BigMagnus6Tips/Sememsterprojekt-grundl-ggende-styring-af-robotter/Images/HardwareIntegrationNoLedOrShield.png

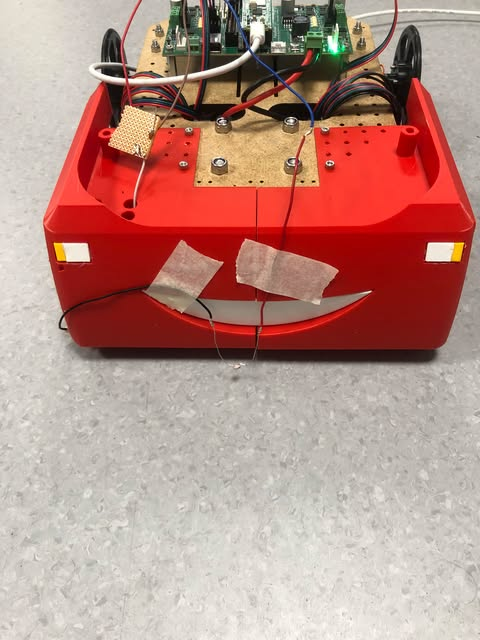
Images/HardwareIntegrationNoLedOrShield.png
