BigMagnus6Tips/Sememsterprojekt-grundl-ggende-styring-af-robotter/Images/Hardware_integration_1.1_pmr3.jpg

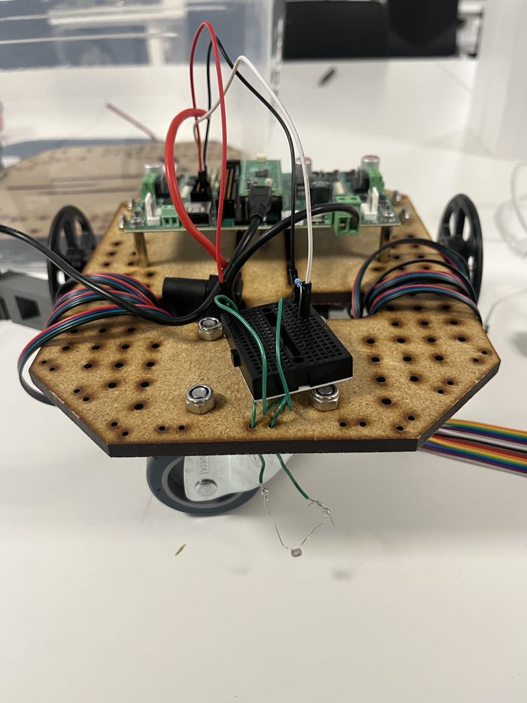
Images/Hardware_integration_1.1_pmr3.jpg
