BigMagnus6Tips/Sememsterprojekt-grundl-ggende-styring-af-robotter/Joystick controlled wireless robot.pptx

## Joystick controlled wireless robot

Lukas, Karl, Magne, Rasmus, Alexander og Nikolai

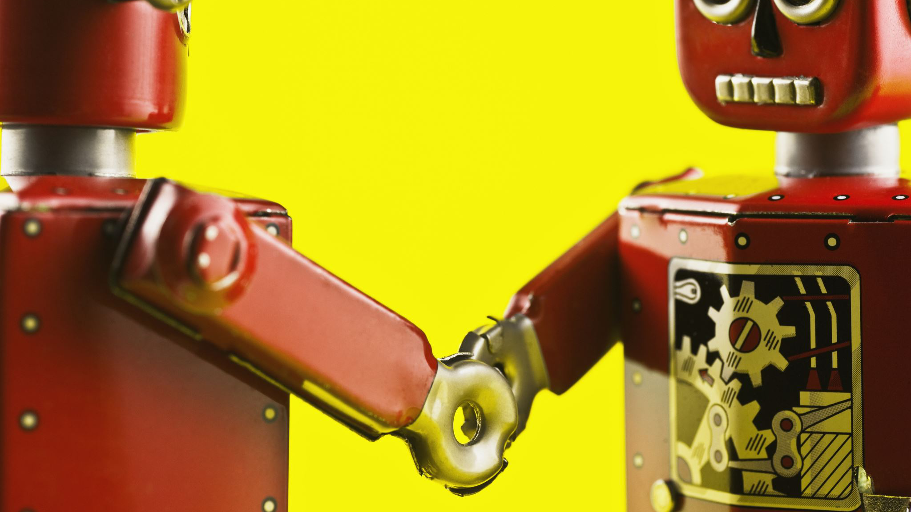
[picture p3: figure]
Toy robots shaking hands

## Introduction

- Concept and Objective

- Movement control
- Speed adjustment
- Controller
- LED’s, OLED, Joystick
- Wireless data communication
- Killswitch

- Solution

- Joystick class
- 3D print + PCB
- Bluetooth

## High-level overview

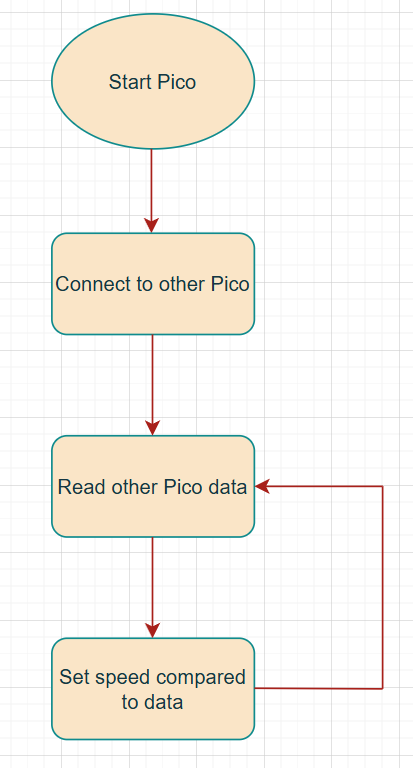
[picture p4: figure]
Et billede, der indeholder tekst, skærmbillede, diagram, linje/række Beskrivelsen er genereret automatisk
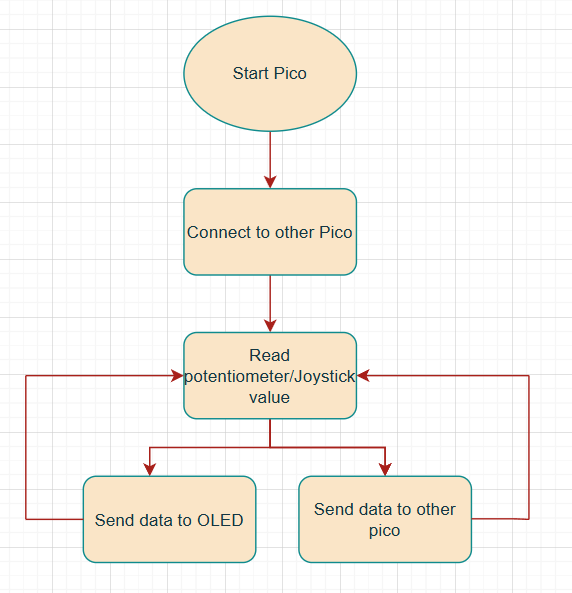
[picture p5: figure]
Et billede, der indeholder tekst, skærmbillede, diagram, Font/skrifttype Beskrivelsen er genereret automatisk

## Tools and Materials

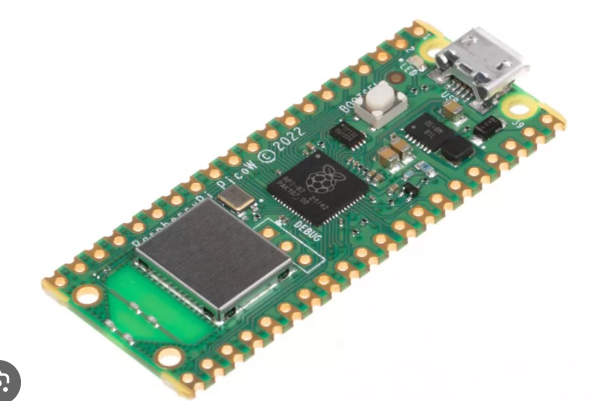
[picture p6: figure]
Et billede, der indeholder elektronik, Elektronisk komponent, Kredsløbskomponent, Passive kredsløbskomponenter Beskrivelsen er genereret automatisk

- Two pico WH’s
- PCB
- 3D print
- Killswitch
- Joystick
- LED
- OLED
- Resistors (2 Kohm)

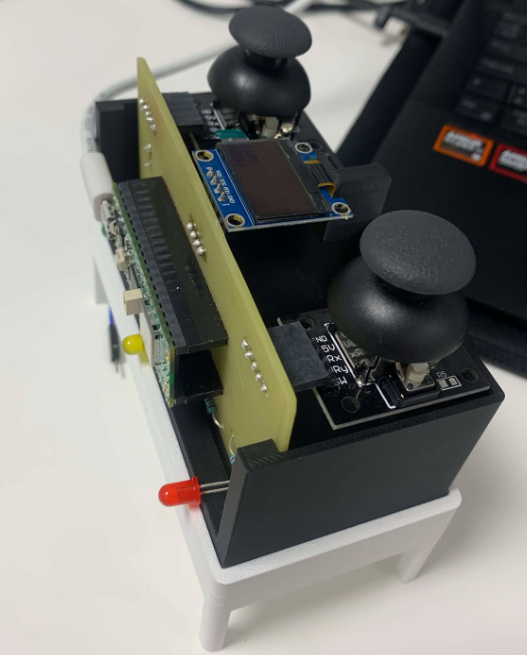
[picture p7: figure]
Et billede, der indeholder elektronik, Elektronisk enhed, Inputenhed, indendørs Beskrivelsen er genereret automatisk
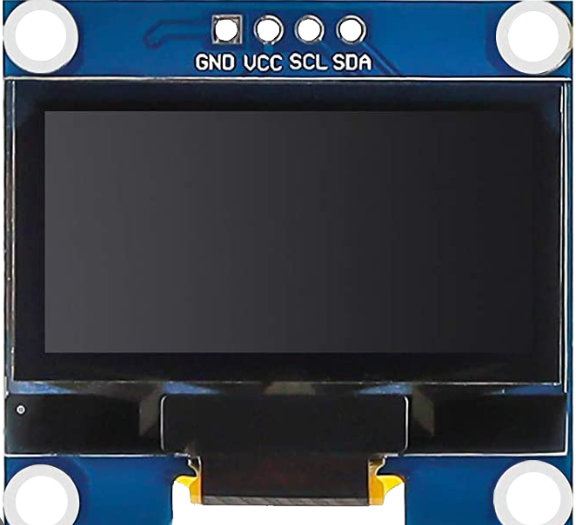
[picture p8: figure]
Et billede, der indeholder tekst, skærm, fjernsyn, skærmbillede Beskrivelsen er genereret automatisk

## Key features

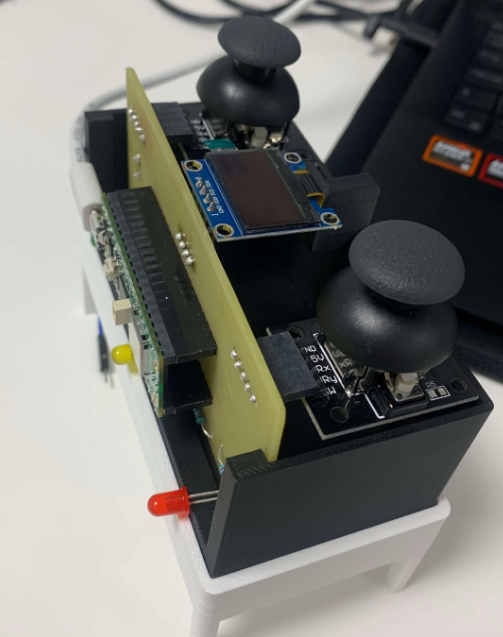
[picture p9: figure]
Et billede, der indeholder elektronik, Elektronisk enhed, Inputenhed, indendørs Beskrivelsen er genereret automatisk

Killswitch functionality
Joystick/Joystick
Move back -> forward -> left -> right
Wireless Bluetooth communication
OLED and LED integration

## Results

- 2 picos
- Bluetooth
- Controller
  - Our own print

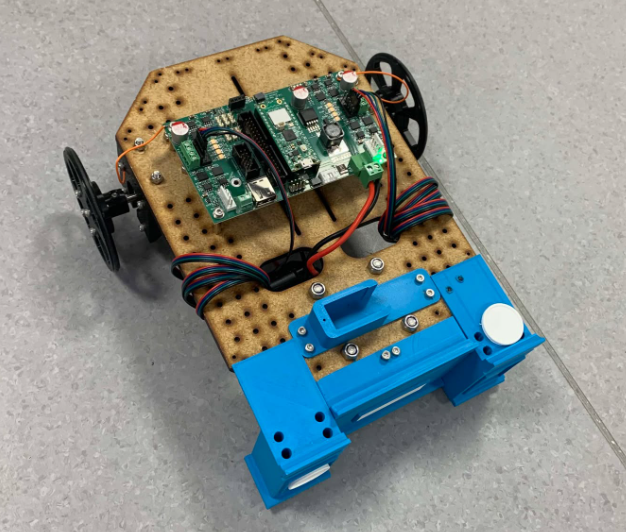
[picture p10: figure]
Et billede, der indeholder Kredsløbskomponent, Elektroteknik, Elektronisk komponent, Passive kredsløbskomponenter Beskrivelsen er genereret automatisk

## Some of the Code Joystick

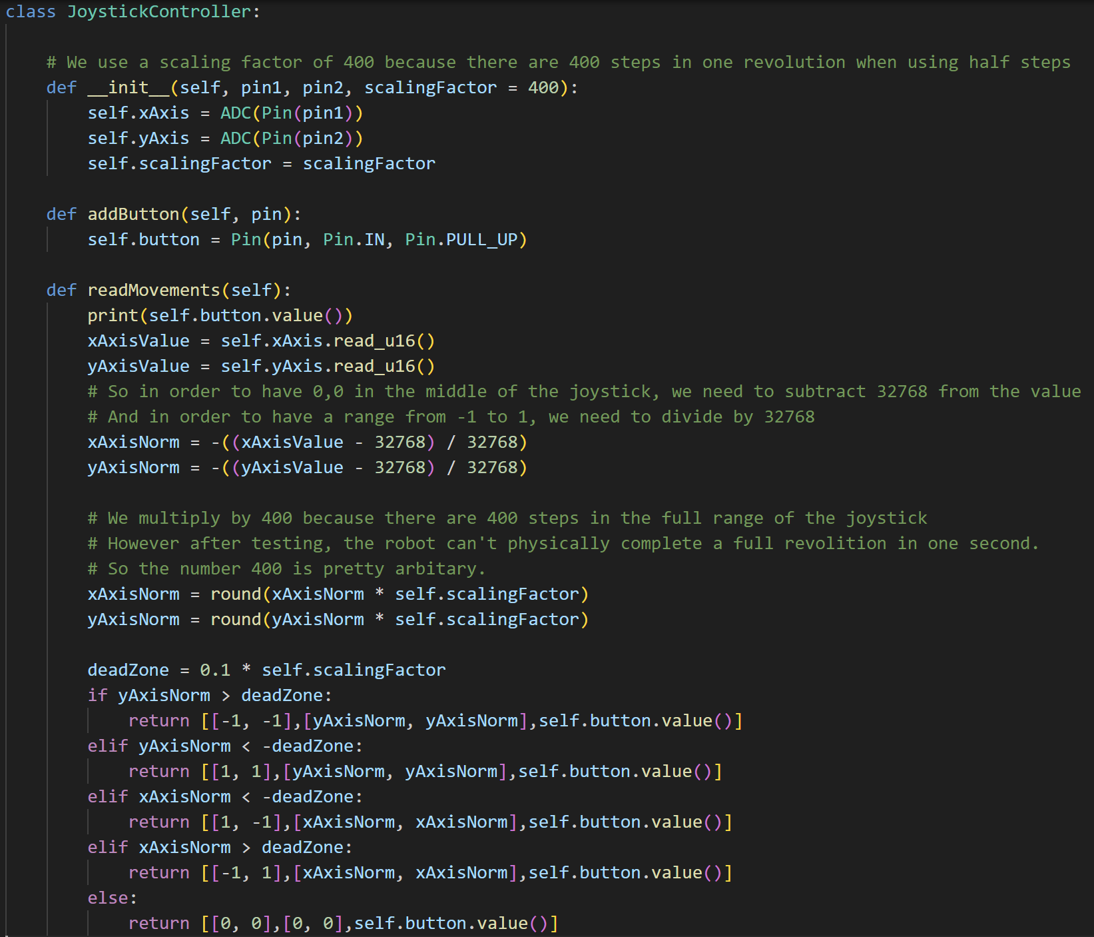
[picture p11: figure]
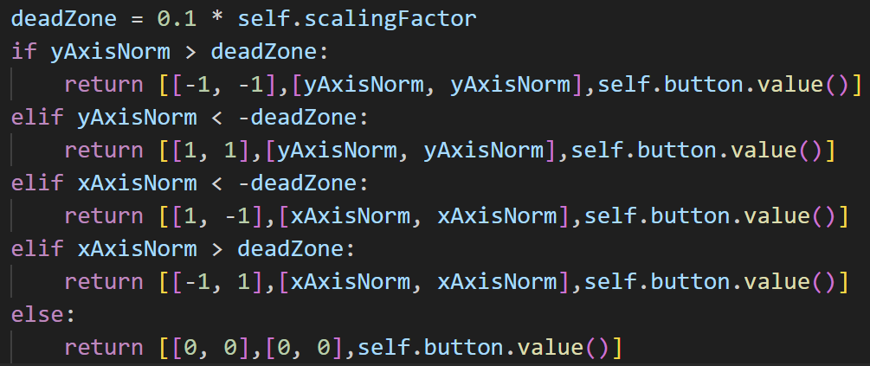
[picture p12: figure]

## Setup for Bluetooth

- Aioble
- Services and Characteristics
- Packets
  - Bytes

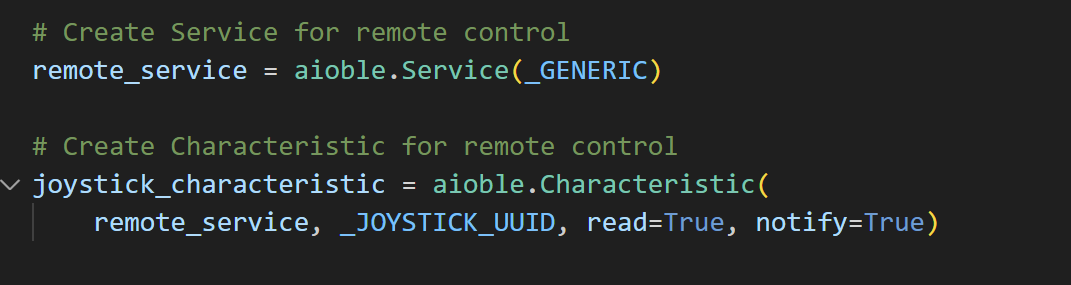
[picture p13: figure]
Et billede, der indeholder tekst, skærmbillede, Font/skrifttype Beskrivelsen er genereret automatisk
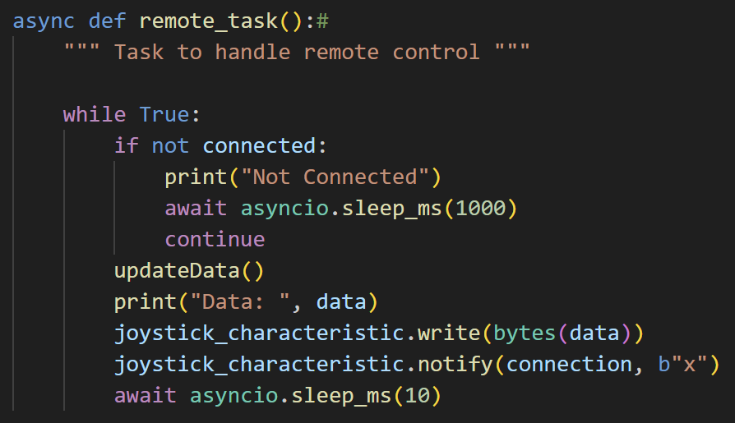
[picture p14: figure]
Et billede, der indeholder tekst, skærmbillede, Font/skrifttype Beskrivelsen er genereret automatisk

## Conversion to bytes

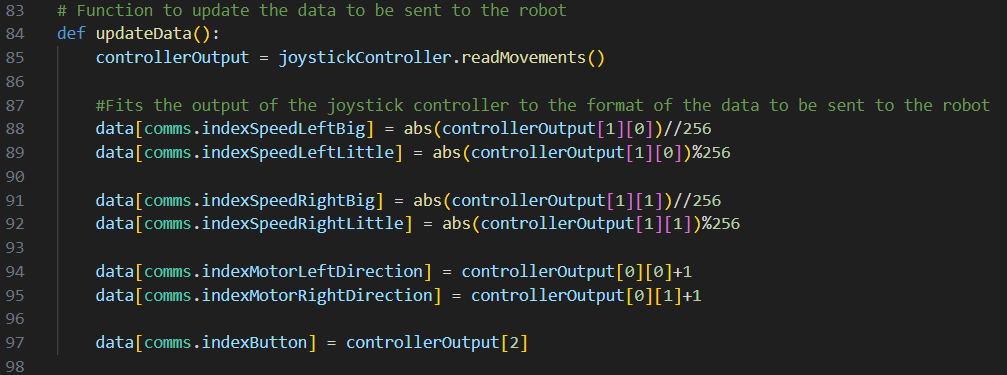
[picture p15: figure]

Bluetooth sends uint8
Bytes is 256 different values

## PrintBoard

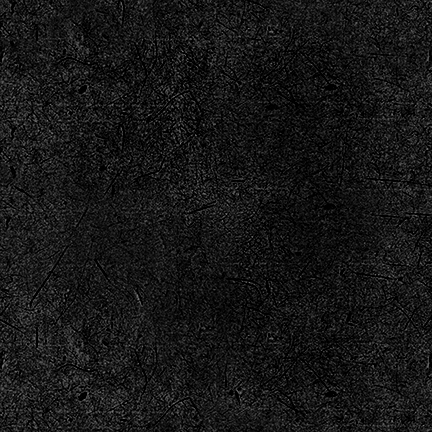
[picture p16: figure]
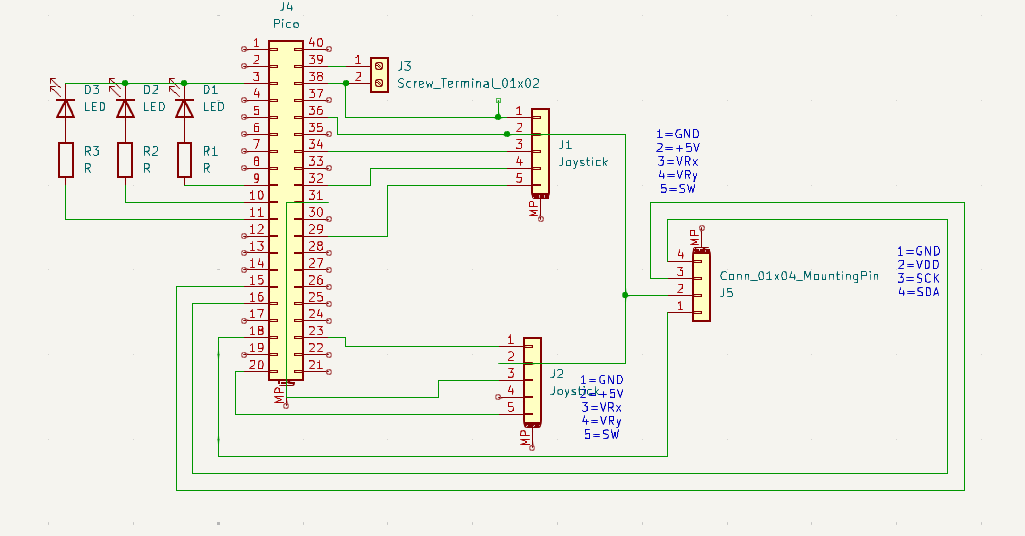
[picture p17: figure]
Et billede, der indeholder tekst, diagram, linje/række, Plan Beskrivelsen er genereret automatisk

KiCad
- Pico
- 2 x Joystick – Mounting pin 1x5
- OLED – Mounting pin 1x4
- Screw terminal
- LED – Pre-resitance
- Etching

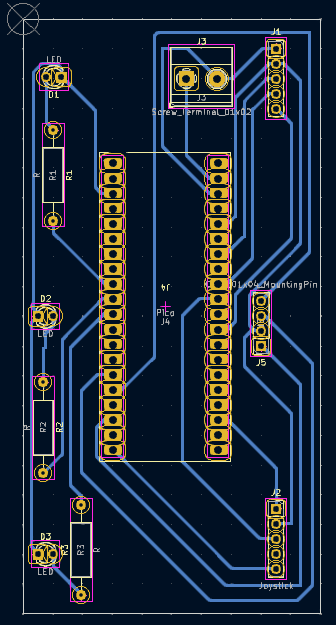
[picture p18: figure]
Et billede, der indeholder tekst, skærmbillede, kredsløb, design Beskrivelsen er genereret automatisk
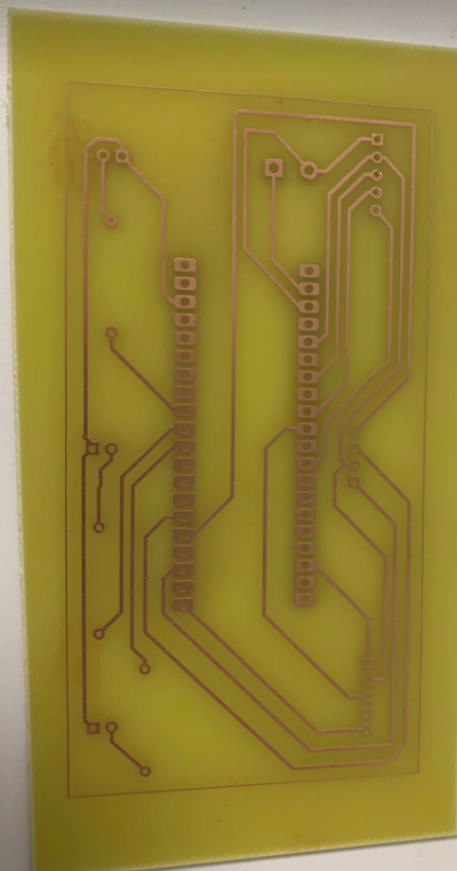
[picture p19: figure]
Et billede, der indeholder kunst, Rektangel, tegning Beskrivelsen er genereret automatisk

## Demonstration

- https://www.youtube.com/watch?v=Fvm5enrU_tU
- Springer lige det første min over... da vi står og forklarer

## Challenges

PCB soldering issues
Wireless wifi communication or bluetooth

## Conclusion and Improvements

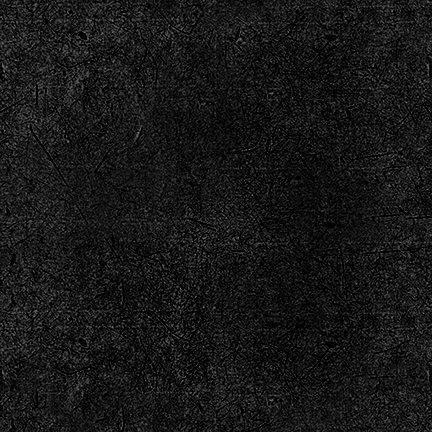
[picture p20: figure]
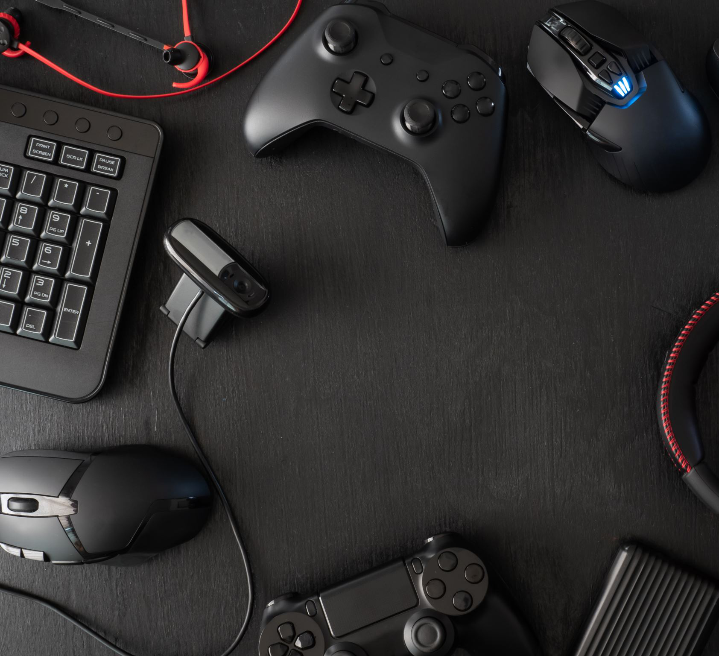
[picture p21: figure]
Gadgets på et skrivebord

- Full joystick control left/forward, right/backward etc.
- Double joystick integration (too few ADC pins)
