BigMagnus6Tips/Sememsterprojekt-grundl-ggende-styring-af-robotter/Images/CrazyPerfectGraph.png

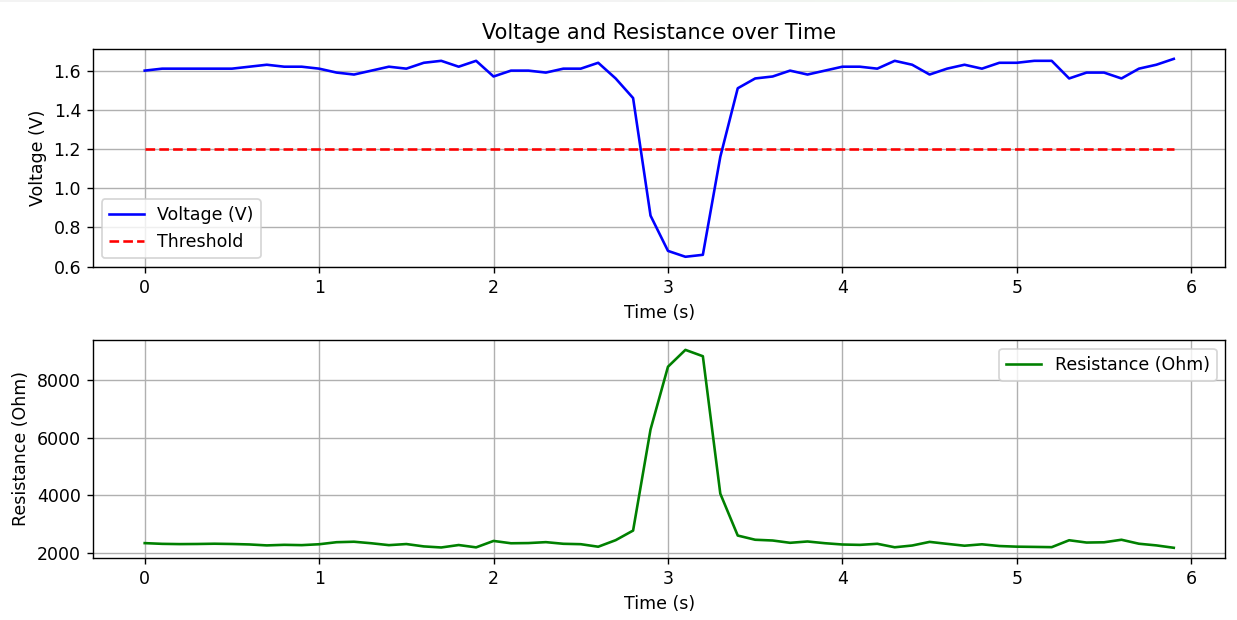
Images/CrazyPerfectGraph.png
