BigMagnus6Tips/Sememsterprojekt-grundl-ggende-styring-af-robotter/Images/Data_log_before_hardware.png

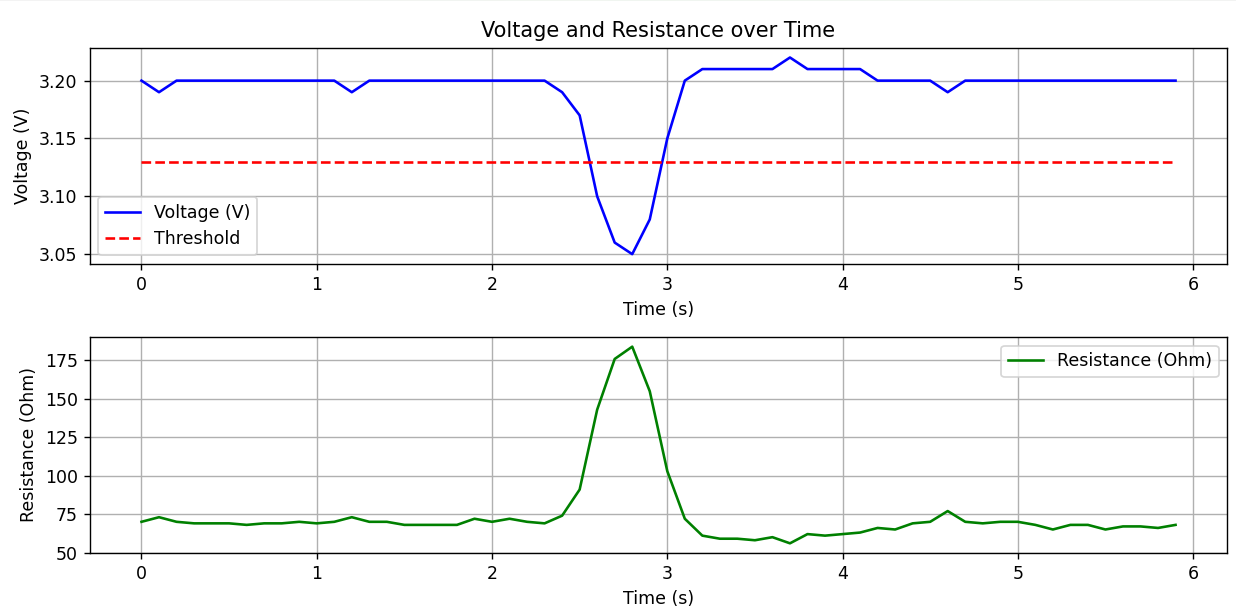
Images/Data_log_before_hardware.png
