BigMagnus6Tips/Sememsterprojekt-grundl-ggende-styring-af-robotter/Images/finalNoLEDButShieldGraph.png

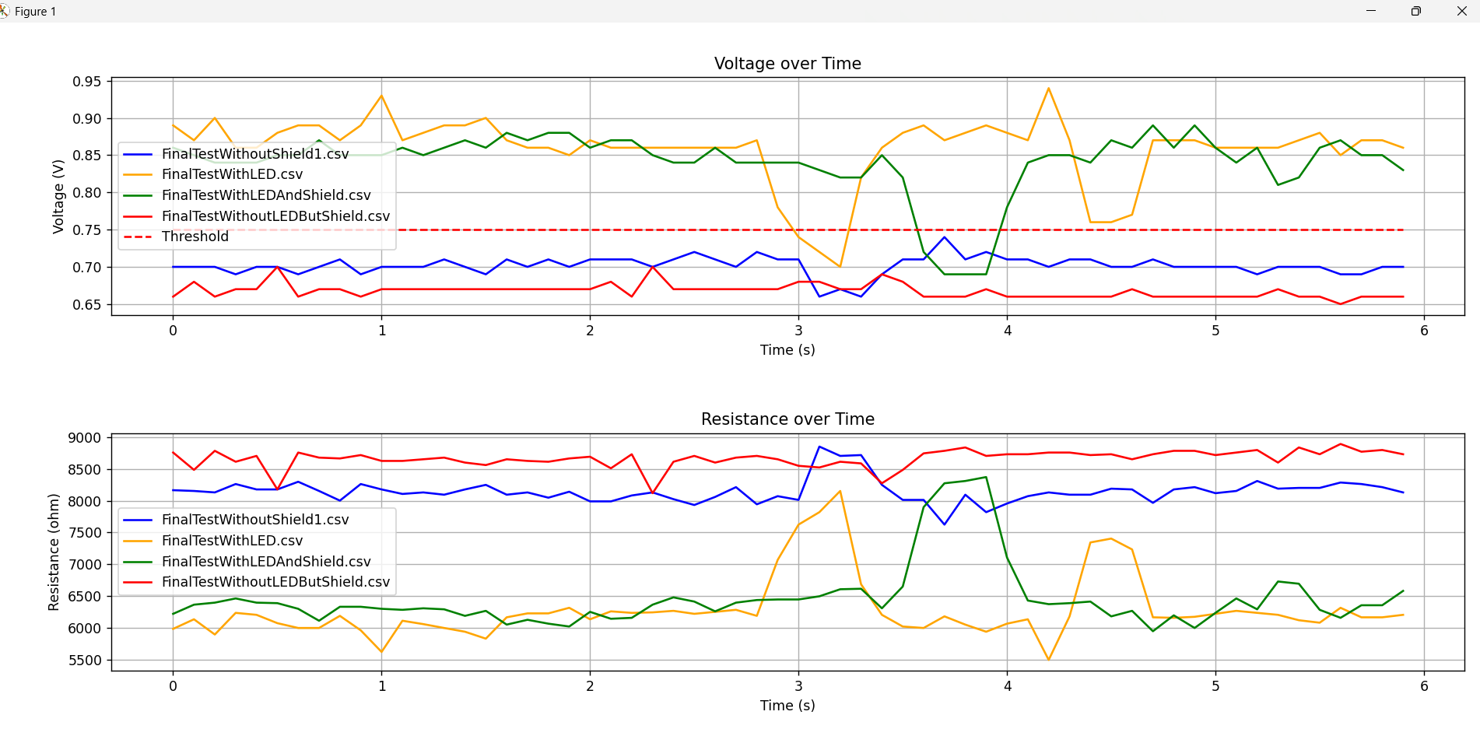
Images/finalNoLEDButShieldGraph.png
