BigMagnus6Tips/Sememsterprojekt-grundl-ggende-styring-af-robotter/Images/finalNoLedOrShield.png

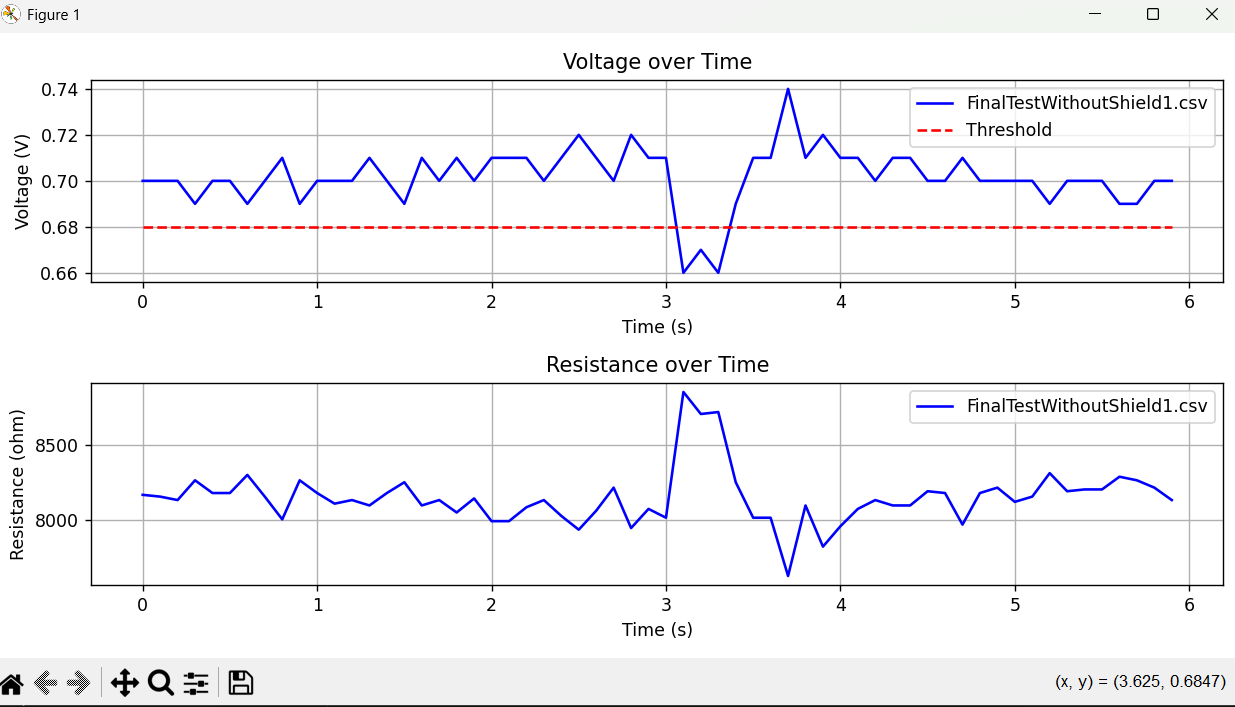
Images/finalNoLedOrShield.png
