BigMagnus6Tips/Sememsterprojekt-grundl-ggende-styring-af-robotter/Images/finalWithLedAndShield.png

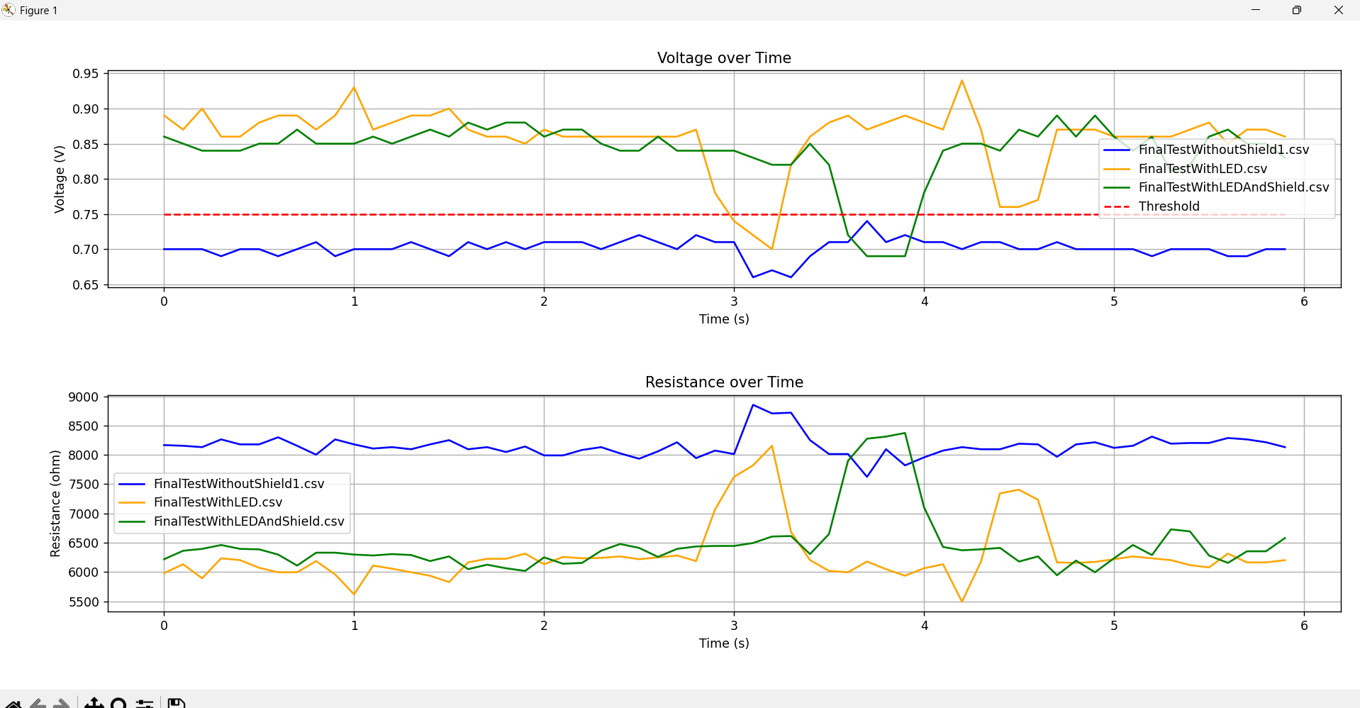
Images/finalWithLedAndShield.png
