BigMagnus6Tips/Sememsterprojekt-grundl-ggende-styring-af-robotter/Images/finalWithLEDNoShield.png

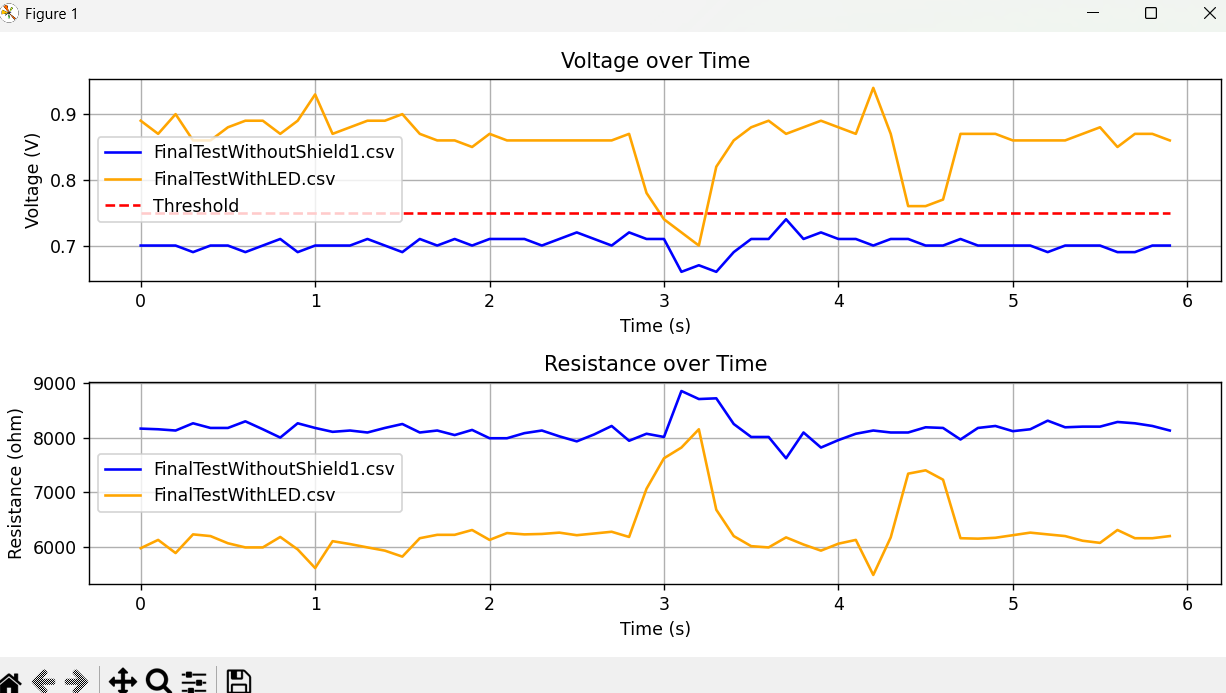
Images/finalWithLEDNoShield.png
