BigMagnus6Tips/Sememsterprojekt-grundl-ggende-styring-af-robotter/Images/Flowchart2.png

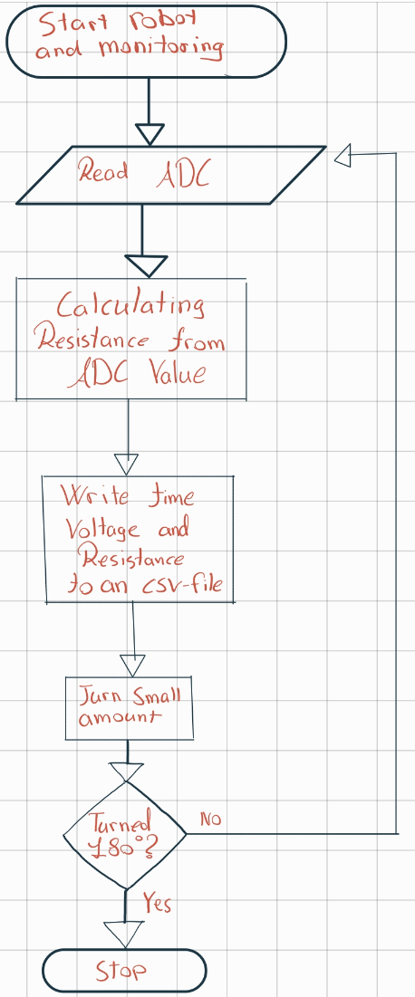
Images/Flowchart2.png
