BigMagnus6Tips/Sememsterprojekt-grundl-ggende-styring-af-robotter/Images/HardwareWithLedAndShield.png

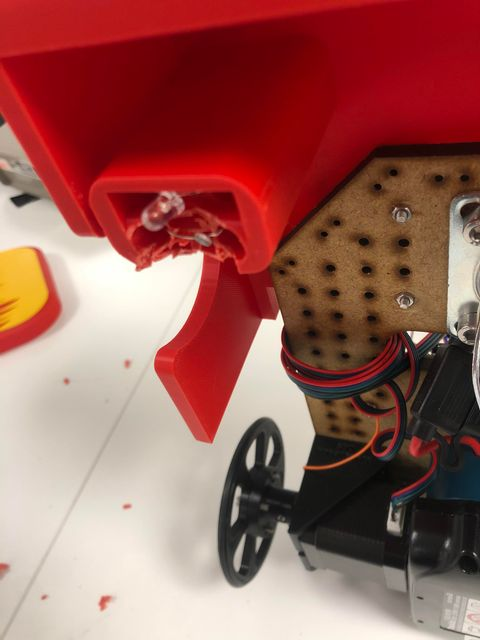
Images/HardwareWithLedAndShield.png
