BigMagnus6Tips/Sememsterprojekt-grundl-ggende-styring-af-robotter/Images/HardwareWithLedNoShiedIntegration.png

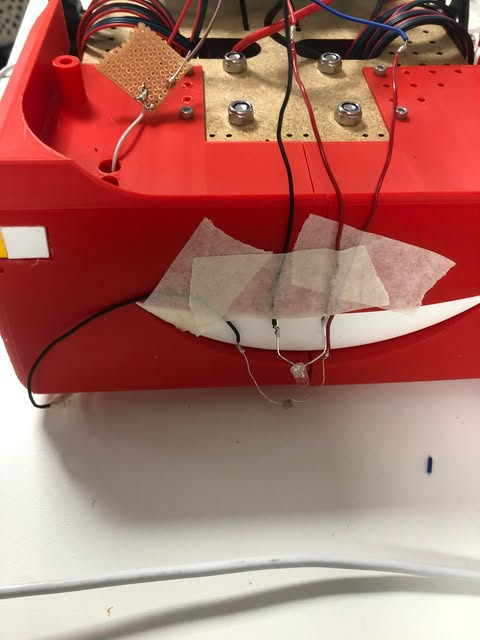
Images/HardwareWithLedNoShiedIntegration.png
