BigMagnus6Tips/Sememsterprojekt-grundl-ggende-styring-af-robotter/Images/LDR_diagram.png

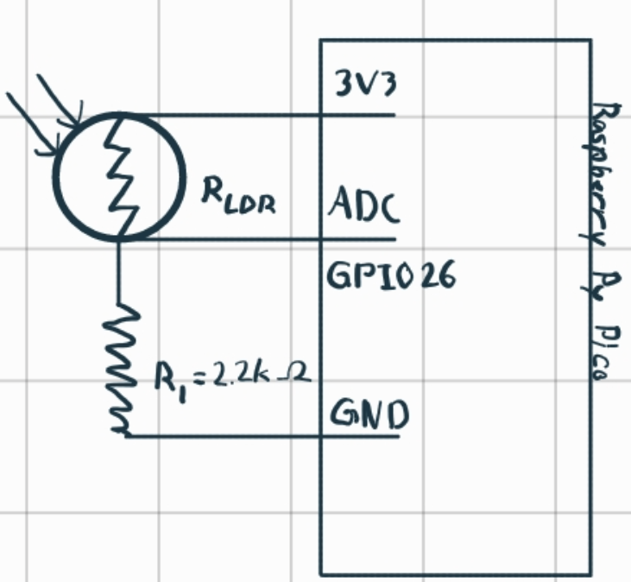
Images/LDR_diagram.png
