BigMagnus6Tips/Sememsterprojekt-grundl-ggende-styring-af-robotter/Images/Ny_Hardware.jpg

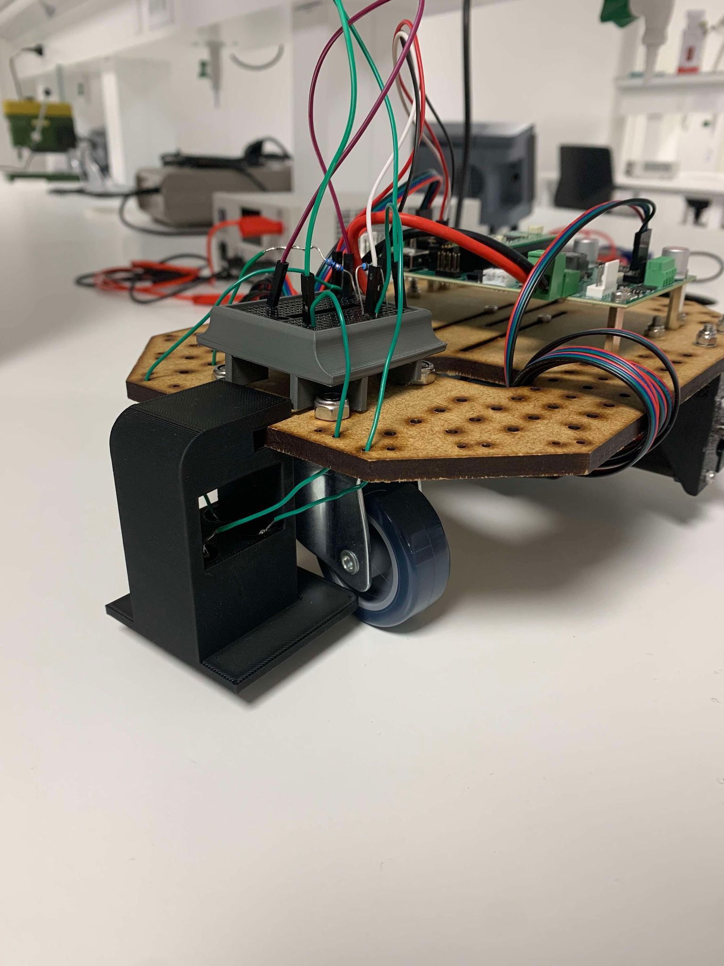
Images/Ny_Hardware.jpg
