BigMagnus6Tips/Sememsterprojekt-grundl-ggende-styring-af-robotter/Images/Ny_Hardware_LDR_LED.jpg

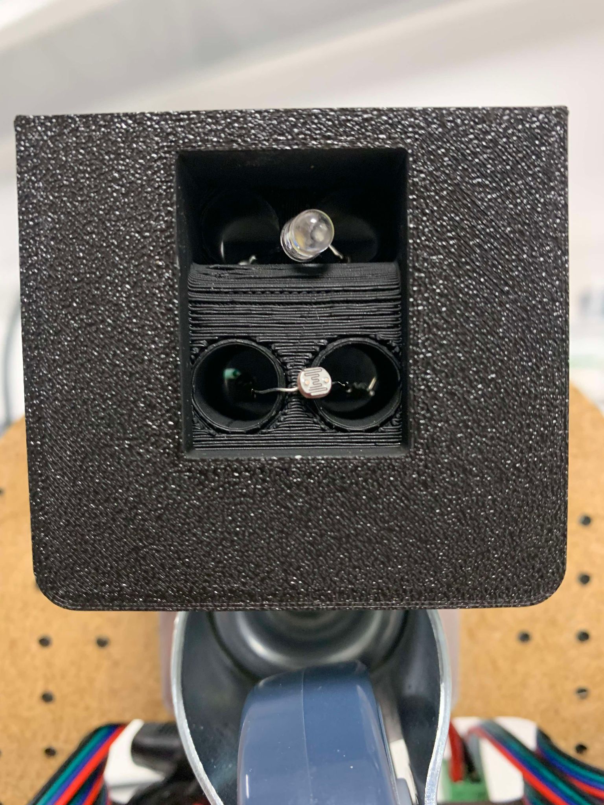
Images/Ny_Hardware_LDR_LED.jpg
