BigMagnus6Tips/Sememsterprojekt-grundl-ggende-styring-af-robotter/Images/PCB Schematics.png

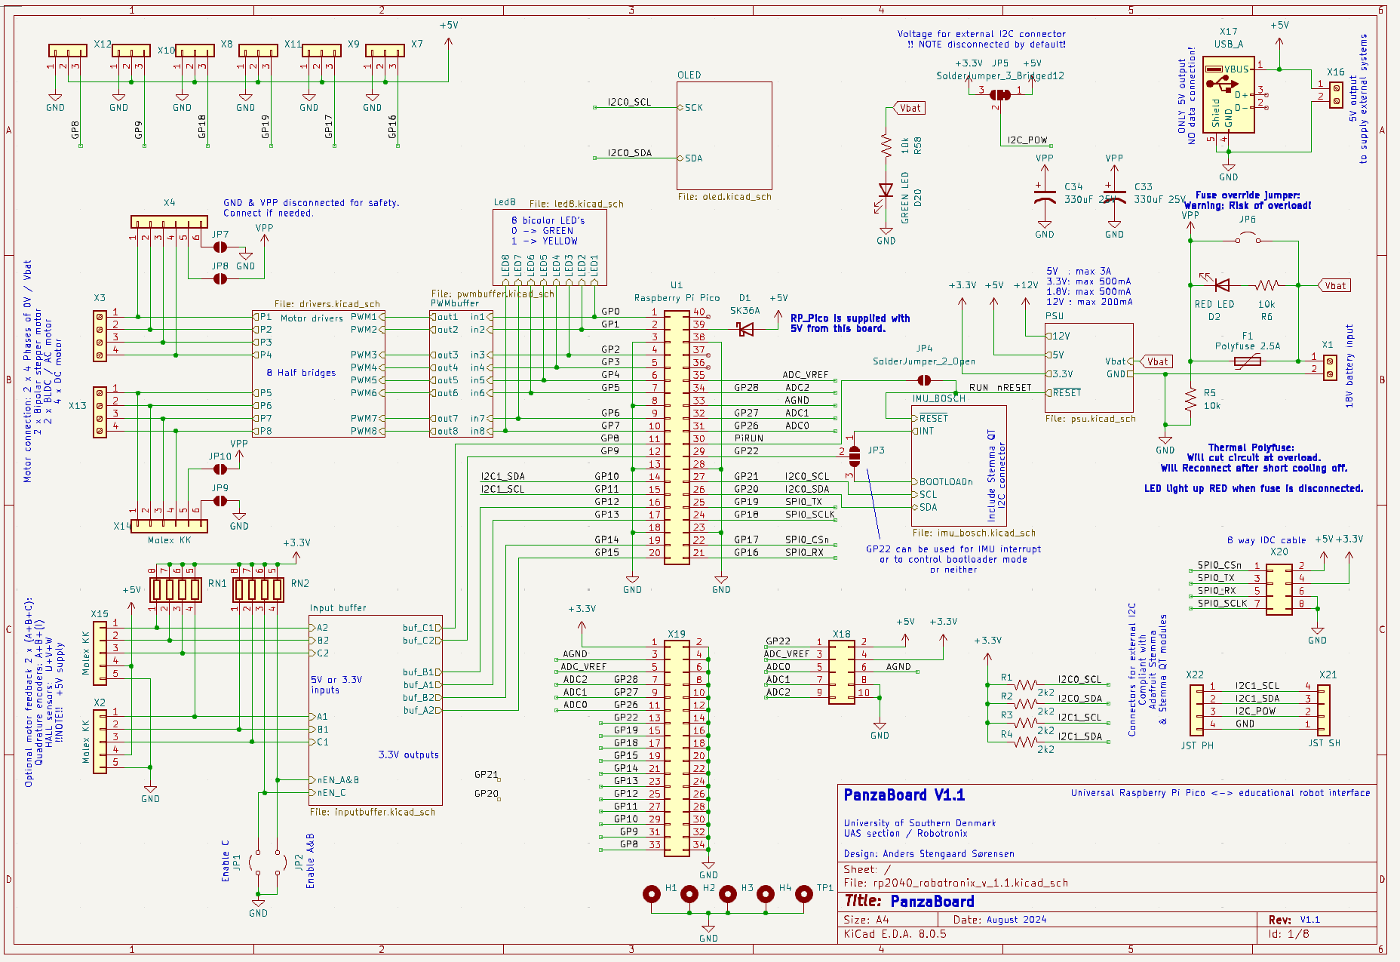
Images/PCB Schematics.png
