BigMagnus6Tips/Sememsterprojekt-grundl-ggende-styring-af-robotter/Images/Pf3 program _241205_130103.jpg

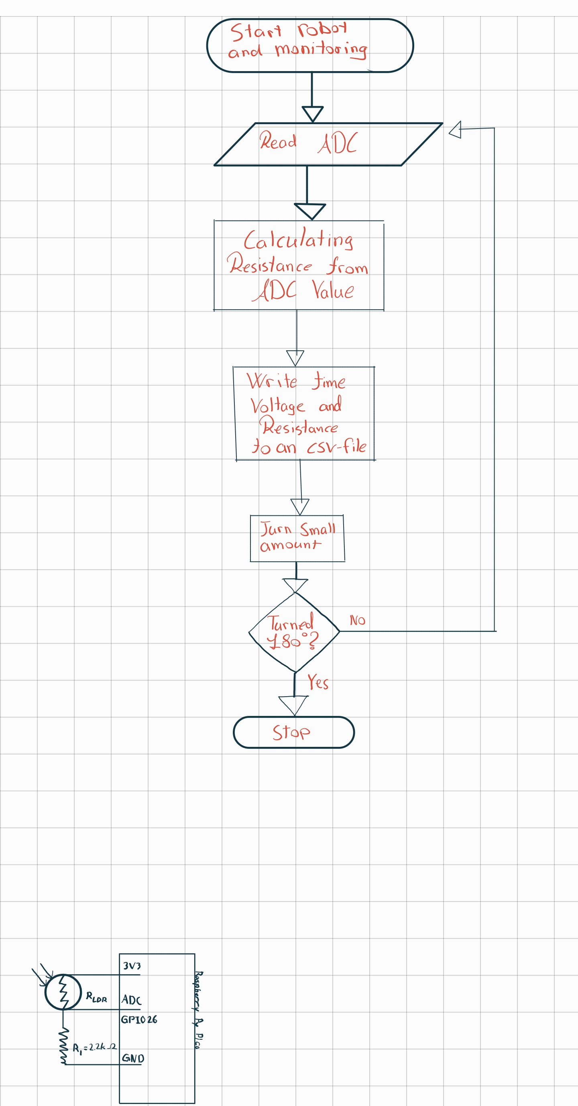
Images/Pf3 program _241205_130103.jpg
