BigMagnus6Tips/Sememsterprojekt-grundl-ggende-styring-af-robotter/Images/Shielded_no_LED.png

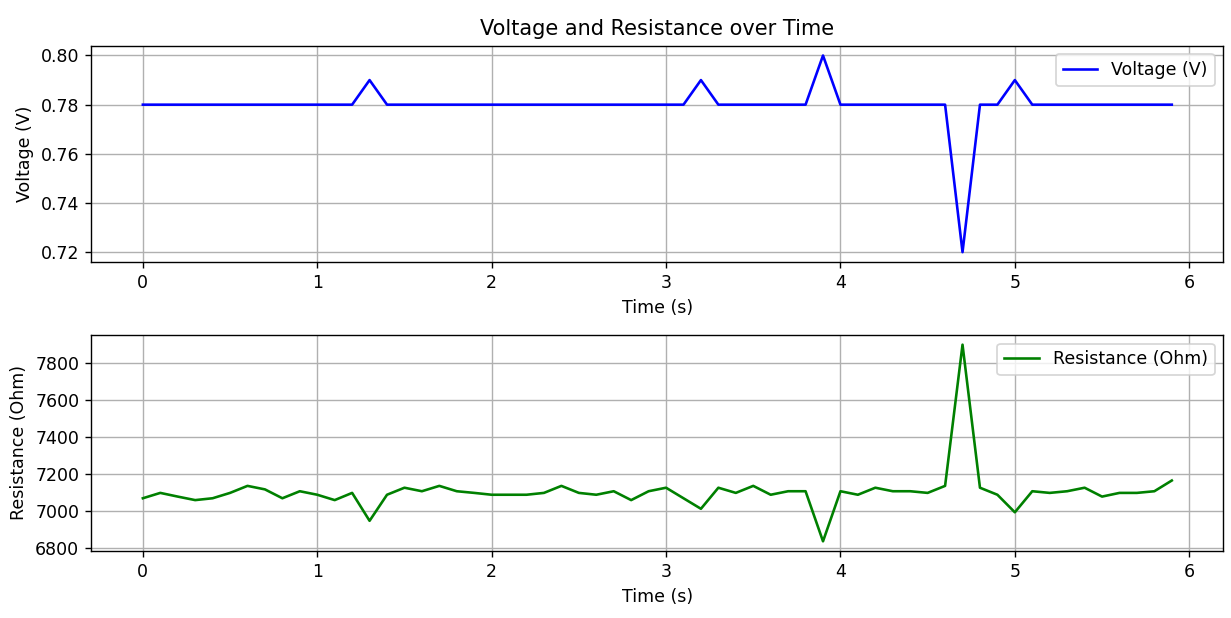
Images/Shielded_no_LED.png
