BigMagnus6Tips/Sememsterprojekt-grundl-ggende-styring-af-robotter/kiCad_LDRcomperator/LDRcomperator.kicad_pcb

## KiCad design kiCad_LDRcomperator/LDRcomperator.kicad_pcb (2025-01-26)

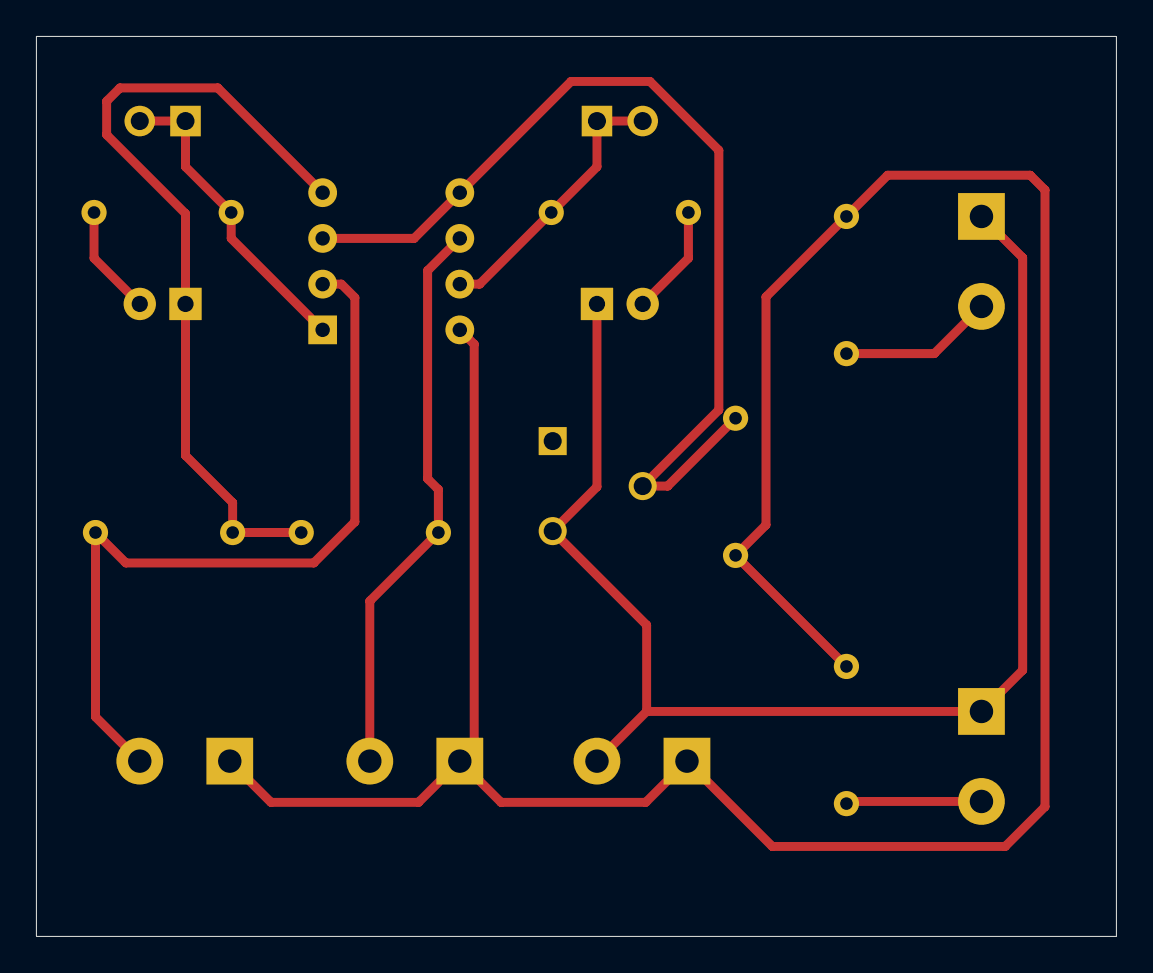
[picture p54: board LDRcomperator.kicad_pcb from above]

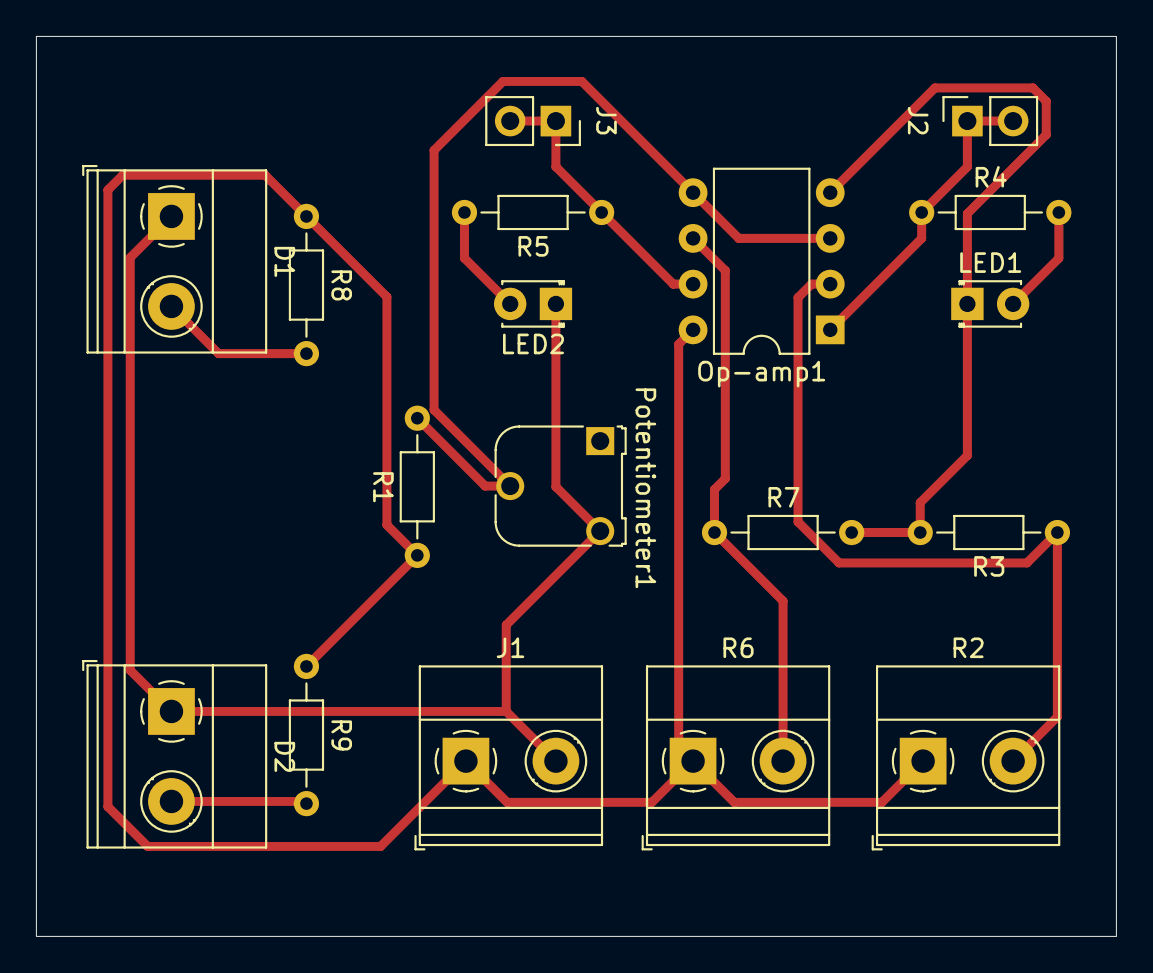
[picture p55: board LDRcomperator.kicad_pcb from below]

Board: 2 copper layers, 60.0 x 50.0 mm, 18 parts (18 on the bottom side), 11 nets.

Parts:
D1, D2: LED; TerminalBlock_Phoenix_MKDS-1,5-2_1x02_P5.00mm_Horizontal
J1: Screw_Terminal_01x02; TerminalBlock_Phoenix_MKDS-1,5-2_1x02_P5.00mm_Horizontal
J2, J3: Conn_01x02_MountingPin; PinSocket_1x02_P2.54mm_Vertical
LED1, LED2: LED; LED_D1.8mm_W3.3mm_H2.4mm
Op-amp1: MCP6001R; DIP-8_W7.62mm
Potentiometer1: 100k ohm; Potentiometer_Runtron_RM-065_Vertical
R1: 22k ohm; R_Axial_DIN0204_L3.6mm_D1.6mm_P7.62mm_Horizontal
R2, R6: LDR03; TerminalBlock_Phoenix_MKDS-1,5-2_1x02_P5.00mm_Horizontal
R3: 2k ohm; R_Axial_DIN0204_L3.6mm_D1.6mm_P7.62mm_Horizontal
R4, R5: 65 ohm; R_Axial_DIN0204_L3.6mm_D1.6mm_P7.62mm_Horizontal
R7: 2,2k ohm; R_Axial_DIN0204_L3.6mm_D1.6mm_P7.62mm_Horizontal
R8, R9: 30; R_Axial_DIN0204_L3.6mm_D1.6mm_P7.62mm_Horizontal

Connections:
+3V3: J1.1, Op-amp1.8 (V+), R1.1, R2.1, R6.1, R8.1, R9.1
GND: D1.1 (K), D2.1 (K), J1.2, LED1.1 (K), LED2.1 (K), Op-amp1.4 (V-), Potentiometer1.3, R3.2, R7.2
unnamed: D1.2 (A), R8.2
unnamed: D2.2 (A), R9.2
unnamed: J2.1, J2.2, Op-amp1.1, R4.1
unnamed: J3.1, J3.2, Op-amp1.7, R5.1
unnamed: LED1.2 (A), R4.2
unnamed: LED2.2 (A), R5.2
unnamed: Op-amp1.3 (+), Op-amp1.5 (+), Potentiometer1.2, R1.2
unnamed: Op-amp1.2 (-), R2.2, R3.1
unnamed: Op-amp1.6 (-), R6.2, R7.1
