BigMagnus6Tips/Sememsterprojekt-grundl-ggende-styring-af-robotter/kiCad_OLED_and_button/kiCad_OLED_and_button.kicad_pcb

## KiCad design kiCad_OLED_and_button/kiCad_OLED_and_button.kicad_pcb (2025-01-06)

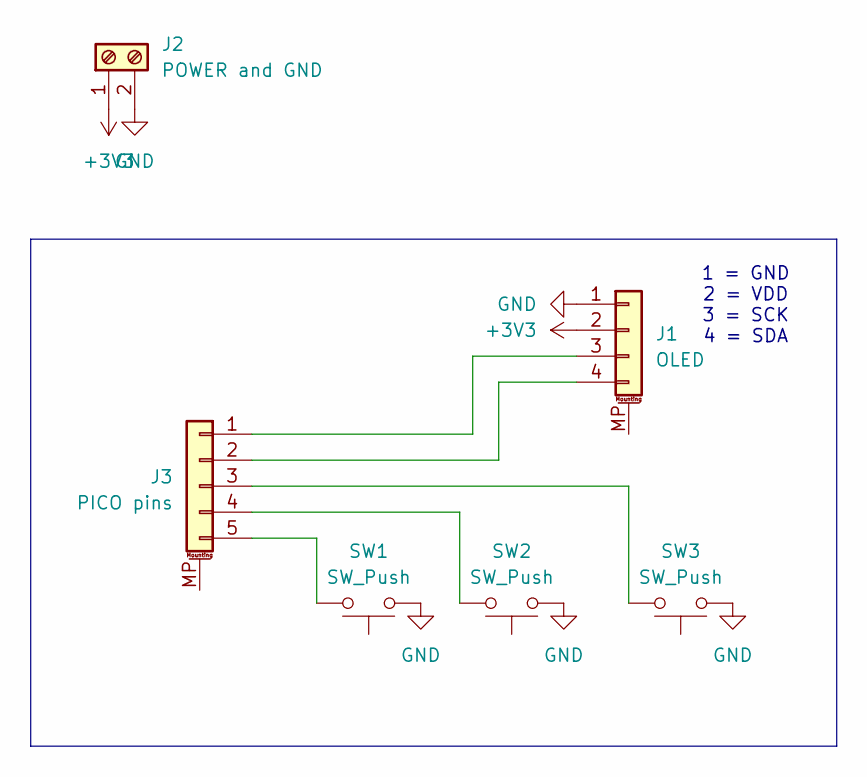
[picture p56: schematic kiCad_OLED_and_button.kicad_sch]

Parts:
J1: OLED; PinSocket_1x04_P2.54mm_Vertical
J2: POWER and GND; TerminalBlock_Phoenix_MKDS-1,5-2_1x02_P5.00mm_Horizontal
J3: PICO pins; PinSocket_1x05_P2.54mm_Vertical
SW1, SW2, SW3: SW_Push; SW_PUSH_6mm_H4.3mm

Connections:
+3V3: J1.2 (VDD), J2.1
GND: J1.1 (GND), J2.2, SW1.1, SW2.1, SW3.1
unnamed: J1.3 (SCK), J3.1
unnamed: J1.4 (SDA), J3.2
unnamed: J3.3, SW3.2
unnamed: J3.4, SW2.2
unnamed: J3.5, SW1.2

Notes on the sheet:
1 = GND 2 = VDD 3 = SCK 4 = SDA

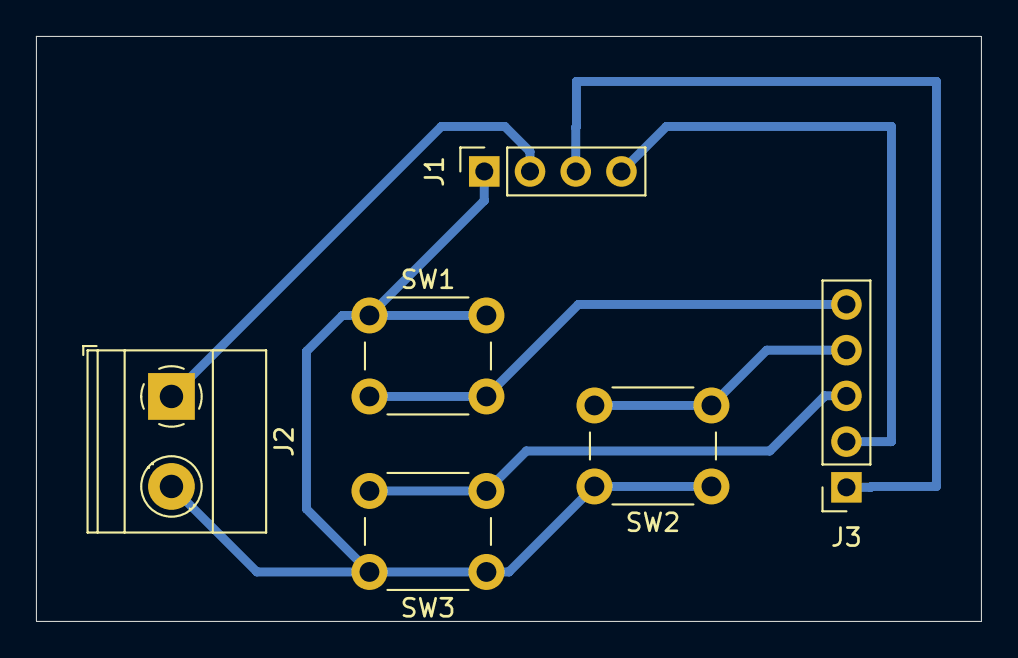
[picture p57: board kiCad_OLED_and_button.kicad_pcb from above]

Board: 2 copper layers, 52.5 x 32.5 mm, 6 parts (0 on the bottom side), 7 nets.
