BigMagnus6Tips/Sememsterprojekt-grundl-ggende-styring-af-robotter/KiCad_Elektromagnet/Elektromagnet print/Elektromagnet print.kicad_pcb

## KiCad design KiCad_Elektromagnet/Elektromagnet print/Elektromagnet print.kicad_pcb (2024-12-17)

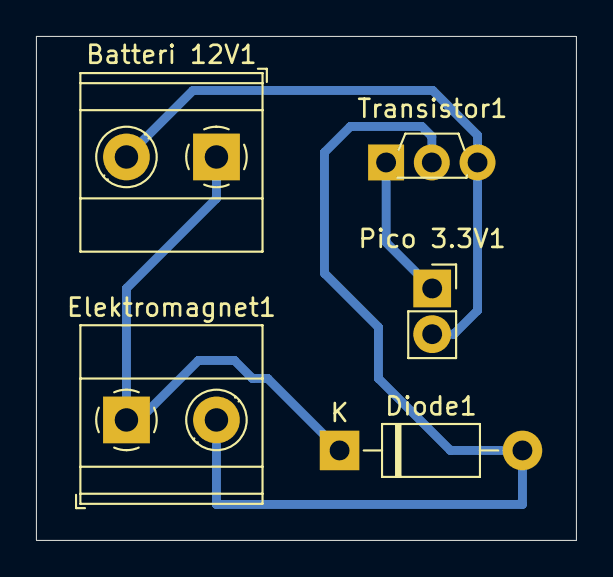
[picture p58: board Elektromagnet print.kicad_pcb from above]

Board: 2 copper layers, 30.0 x 28.0 mm, 5 parts (0 on the bottom side), 4 nets.

Parts:
Batteri 12V1: Screw_Terminal_01x02; TerminalBlock_Phoenix_MKDS-1,5-2_1x02_P5.00mm_Horizontal
Diode1: 1N4001; D_DO-41_SOD81_P10.16mm_Horizontal
Elektromagnet1: L; TerminalBlock_Phoenix_MKDS-1,5-2_1x02_P5.00mm_Horizontal
Pico 3.3V1: Conn_01x01_Pin; PinSocket_1x02_P2.54mm_Vertical
Transistor1: 2N7000; TO-92S_Wide

Connections:
GND: Batteri 12V1.2, Pico 3.3V1.2 (Pin_1), Transistor1.3 (D)
unnamed: Batteri 12V1.1, Diode1.1 (K), Elektromagnet1.1
unnamed: Diode1.2 (A), Elektromagnet1.2, Transistor1.2 (G)
unnamed: Pico 3.3V1.1, Transistor1.1 (S)
