BigMagnus6Tips/Sememsterprojekt-grundl-ggende-styring-af-robotter/PCB_kiCad/rp2040_robotronix_v_1.1.kicad_pcb

## KiCad design PCB_kiCad/rp2040_robotronix_v_1.1.kicad_pcb (2024-12-16)

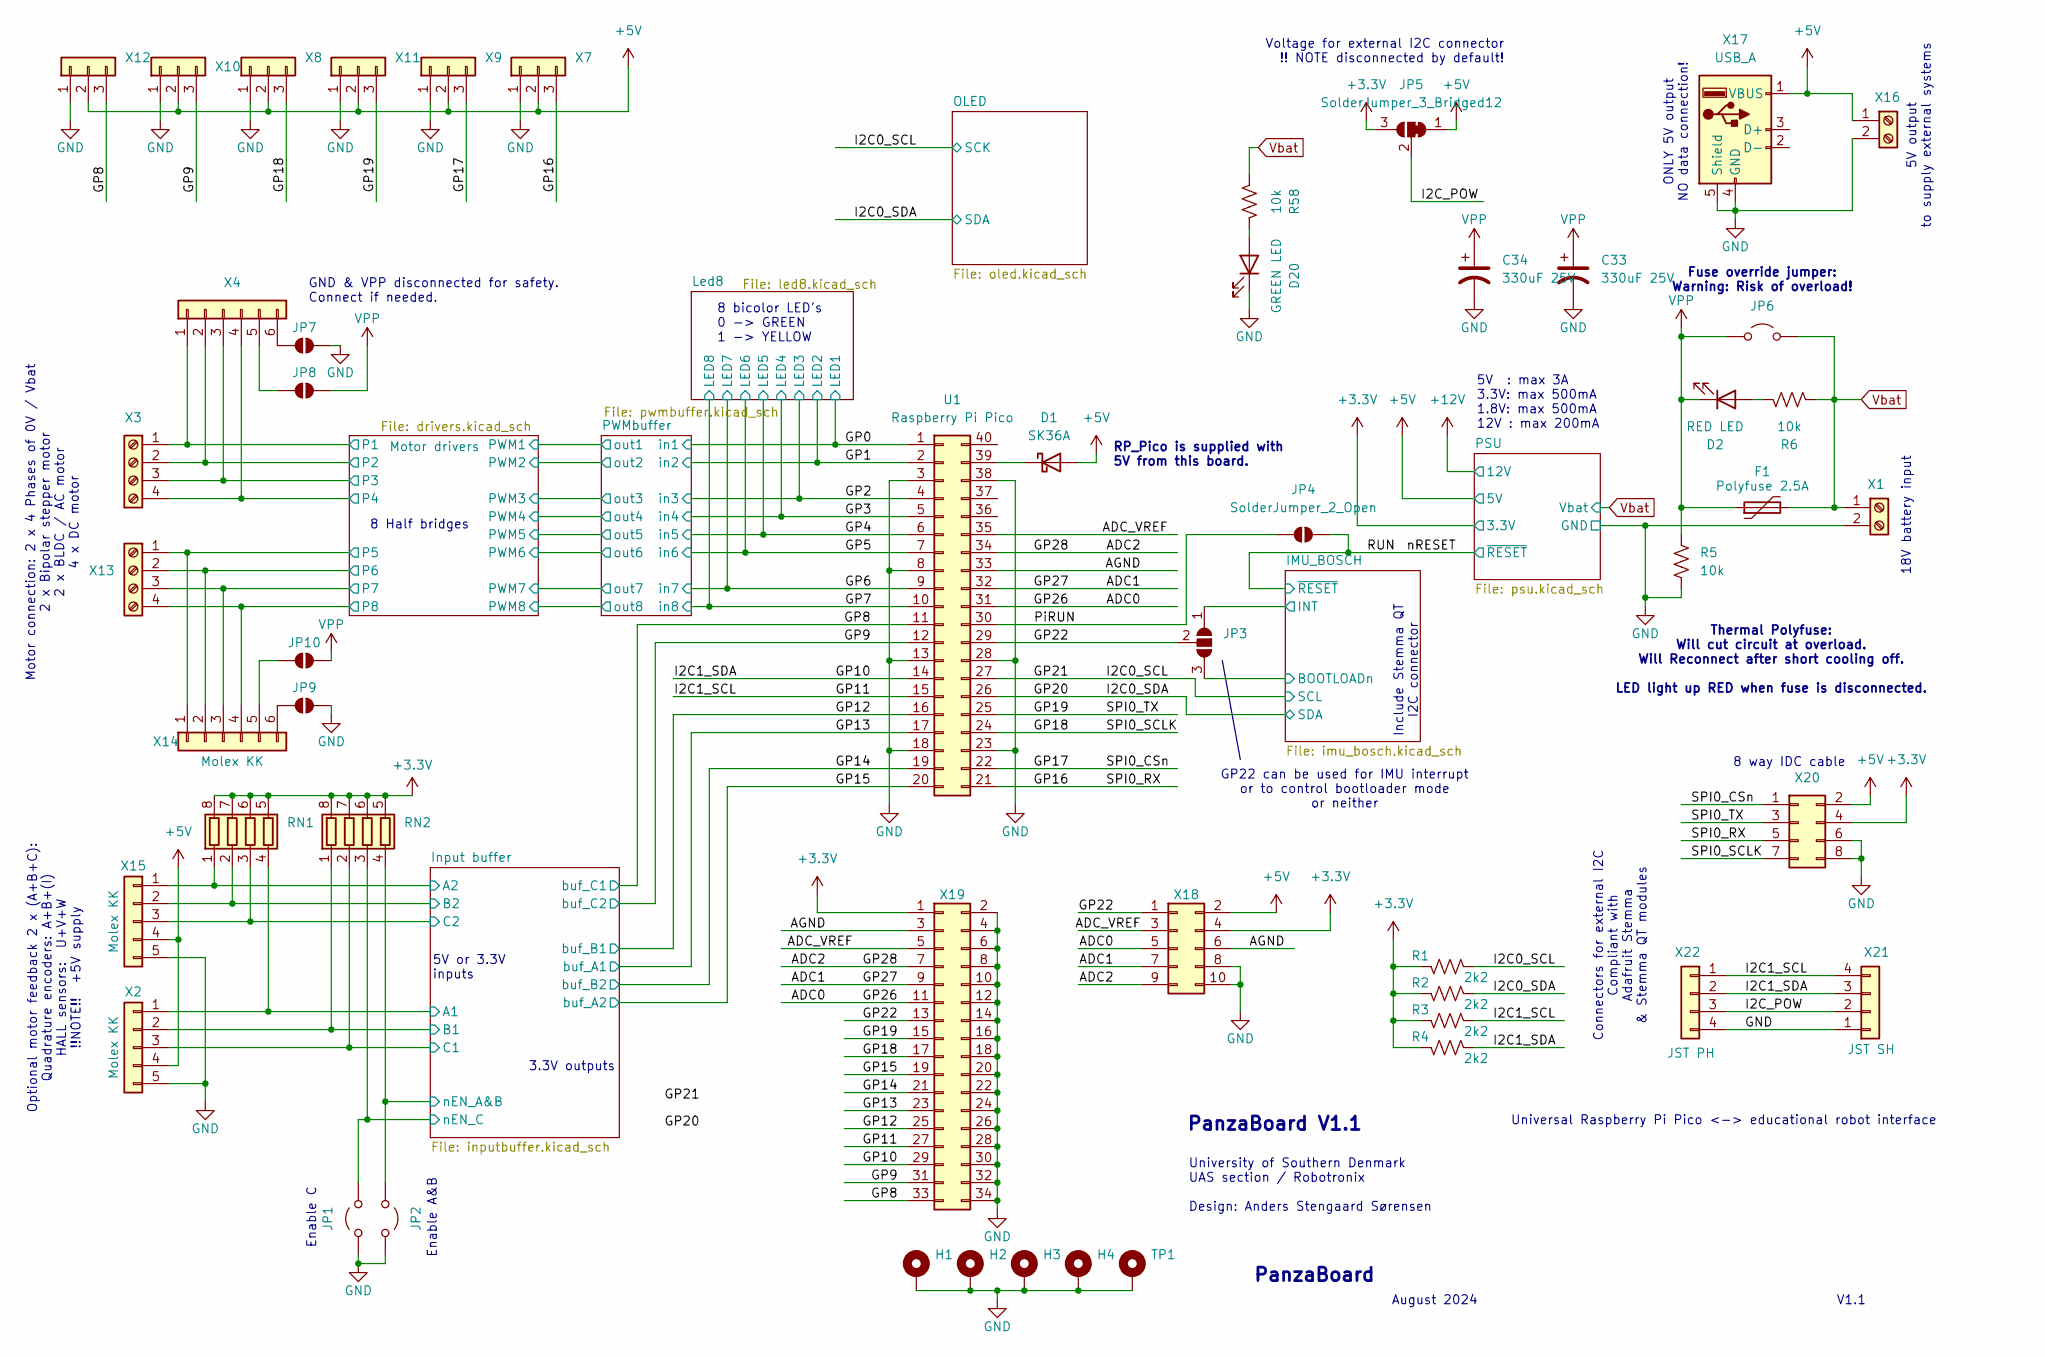
[picture p59: schematic rp2040_robotronix_v_1.1.kicad_sch]

Parts:
C33, C34: 330uF 25V; CP_Radial_D10.0mm_P5.00mm; MFR# Wurth Elektronik
D1: SK36A; D_SMA; MFR# Micro Commercial Components (MCC)
D2: RED LED; LED_0603_1608Metric; MFR# Wurth Elektronik
D20: GREEN LED; LED_0603_1608Metric; MFR# Wurth Elektronik
F1: Polyfuse 2.5A; Fuse_2920_7451Metric; MFR# Littlefuse
H1, H2, H3, H4: MountingHole_Pad; MountingHole_3.2mm_M3_Pad
JP1, JP2, JP6: Jumper_2_Open; SolderJumper-2_P1.3mm_Open_TrianglePad1.0x1.5mm
JP3: SolderJumper_3_Open; PinHeader_1x03_P2.54mm_Vertical
JP4, JP7, JP8, JP9, JP10: SolderJumper_2_Open; SolderJumper-2_P1.3mm_Open_Pad1.0x1.5mm
JP5: SolderJumper_3_Bridged12; SolderJumper-3_P1.3mm_Bridged12_Pad1.0x1.5mm_NumberLabels
R1, R2, R3, R4: 2k2; R_0603_1608Metric
R5, R6, R58: 10k; R_0603_1608Metric
RN1, RN2: 10k; R_Array_Convex_4x0402
TP1: MountingHole_Pad; MountingHole_3.2mm_M3_Pad
U1: Raspberry Pi Pico; RP_pico
X1: Screw_Terminal_01x02; TerminalBlock_Phoenix_PT-1,5-2-5.0-H_1x02_P5.00mm_Horizontal; MFR# Amphenol Anytek
X2, X15: Molex KK; Molex_KK-254_AE-6410-05A_1x05_P2.54mm_Vertical
X3, X13: Screw_Terminal_01x04; TerminalBlock_Phoenix_PT-1,5-4-3.5-H_1x04_P3.50mm_Horizontal; MFR# Phoenix Contact
X4: Conn_01x06; Molex_KK-254_AE-6410-06A_1x06_P2.54mm_Vertical
X7, X8, X9, X10, X11, X12: Conn_01x03; PinHeader_1x03_P2.54mm_Vertical
X14: Molex KK; Molex_KK-254_AE-6410-06A_1x06_P2.54mm_Vertical
X16: Screw_Terminal_01x02; TerminalBlock_Phoenix_PT-1,5-2-3.5-H_1x02_P3.50mm_Horizontal
X17: USB_A; USB_A_Molex_67643_Horizontal
X18: Conn_02x05_Odd_Even; IDC-Header_2x05_P2.54mm_Vertical
X19: Conn_02x17_Odd_Even; IDC-Header_2x17_P2.54mm_Vertical
X20: Conn_02x04_Odd_Even; PinHeader_2x04_P2.54mm_Vertical
X21: JST SH; JST_SH_SM04B-SRSS-TB_1x04-1MP_P1.00mm_Horizontal
X22: JST PH; JST_PH_S4B-PH-K_1x04_P2.00mm_Horizontal

Connections:
+5V: D1.2 (A), JP5.1 (A), X2.4, X7.2, X8.2, X9.2, X10.2, X11.2, X12.2, X15.4, X16.1, X17.1 (VBUS), X18.2, X20.2; also elsewhere on the board
/ADC0: U1.31, X18.5, X19.11
/ADC1: U1.32, X18.7, X19.9
/ADC2: U1.34, X18.9, X19.7
/ADC_VREF: U1.35, X18.3, X19.5
/AGND: U1.33, X18.6, X19.3
/GP0: U1.1; also elsewhere on the board
/GP1: U1.2; also elsewhere on the board
/GP2: U1.4; also elsewhere on the board
/GP3: U1.5; also elsewhere on the board
/GP4: U1.6; also elsewhere on the board
/GP5: U1.7; also elsewhere on the board
/GP6: U1.9; also elsewhere on the board
/GP7: U1.10; also elsewhere on the board
/GP8: U1.11, X12.3, X19.33; also elsewhere on the board
/GP9: U1.12, X10.3, X19.31; also elsewhere on the board
/GP10: R4.2, U1.14, X19.29, X21.3, X22.2
/GP11: R3.2, U1.15, X19.27, X21.4, X22.1
/GP12: U1.16, X19.25; also elsewhere on the board
/GP13: U1.17, X19.23; also elsewhere on the board
/GP14: U1.19, X19.21; also elsewhere on the board
/GP15: U1.20, X19.19; also elsewhere on the board
/GP16: U1.21, X7.3, X20.5
/GP17: U1.22, X9.3, X20.1
/GP18: U1.24, X8.3, X19.17, X20.7
/GP19: U1.25, X11.3, X19.15, X20.3
/GP20: R2.2, U1.26; also elsewhere on the board
/GP21: R1.2, U1.27; also elsewhere on the board
/GP22: JP3.2 (C), U1.29, X18.1, X19.13
/I2C_POW: JP5.2 (C), X21.2, X22.3
/IMU_BOSCH/BOOTLOADn: JP3.3 (B); also elsewhere on the board
/IMU_BOSCH/INT: JP3.1 (A); also elsewhere on the board
/Input buffer/A1: RN1.4 (R4.1), X2.1; also elsewhere on the board
/Input buffer/A2: RN1.1 (R1.1), X15.1; also elsewhere on the board
/Input buffer/B1: RN2.1 (R1.1), X2.2; also elsewhere on the board
/Input buffer/B2: RN1.2 (R2.1), X15.2; also elsewhere on the board
/Input buffer/C1: RN2.2 (R2.1), X2.3; also elsewhere on the board
/Input buffer/C2: RN1.3 (R3.1), X15.3; also elsewhere on the board
/Input buffer/nEN_A&B: JP2.2 (B), RN2.4 (R4.1); also elsewhere on the board
/Input buffer/nEN_C: JP1.2 (B), RN2.3 (R3.1); also elsewhere on the board
/Motor drivers/P1: X3.1, X4.1; also elsewhere on the board
/Motor drivers/P2: X3.2, X4.2; also elsewhere on the board
/Motor drivers/P3: X3.3, X4.3; also elsewhere on the board
/Motor drivers/P4: X3.4, X4.4; also elsewhere on the board
/Motor drivers/P5: X13.1, X14.1; also elsewhere on the board
/Motor drivers/P6: X13.2, X14.2; also elsewhere on the board
/Motor drivers/P7: X13.3, X14.3; also elsewhere on the board
/Motor drivers/P8: X13.4, X14.4; also elsewhere on the board
/PiRUN: JP4.1 (A), U1.30
/RUN: JP4.2 (B); also elsewhere on the board
GND: C33.2, C34.2, D20.1 (K), H1.1, H2.1, H3.1, H4.1, JP1.1 (A), JP2.1 (A), JP7.2 (B), JP9.2 (B), R5.1, TP1.1, U1.3, U1.8, U1.13, U1.18, U1.23, U1.28, U1.38, X1.2, X2.5, X7.1, X8.1, X9.1, X10.1, X11.1, X12.1, X15.5, X16.2, X17.4 (GND), X17.5 (Shield), X18.8, X18.10, X19.2, X19.4, X19.6, X19.8, X19.10, X19.12, X19.14, X19.16, X19.18, X19.20, X19.22, X19.24, X19.26, X19.28, X19.30, X19.32, X19.34, X20.6, X20.8, X21.1, X22.4; also elsewhere on the board
unnamed: D1.1 (K), U1.39
unnamed: D2.2 (A), R6.1
unnamed: D20.2 (A), R58.1
unnamed: JP7.1 (A), X4.6
unnamed: JP8.1 (A), X4.5
unnamed: JP9.1 (A), X14.6
unnamed: JP10.1 (A), X14.5
SD: JP5.3 (B), R1.1, R2.1, R3.1, R4.1, RN1.5 (R4.2), RN1.6 (R3.2), RN1.7 (R2.2), RN1.8 (R1.2), RN2.5 (R4.2), RN2.6 (R3.2), RN2.7 (R2.2), RN2.8 (R1.2), X18.4, X19.1, X20.4; also elsewhere on the board
VPP: C33.1, C34.1, D2.1 (K), F1.1, JP6.1 (A), JP8.2 (B), JP10.2 (B), R5.2; also elsewhere on the board
Vbat: F1.2, JP6.2 (B), R6.2, R58.2, X1.1; also elsewhere on the board

Notes on the sheet:
8 bicolor LED's 0 -> GREEN 1 -> YELLOW
Motor connection: 2 x 4 Phases of 0V / Vbat 2 x Bipolar stepper motor 2 x BLDC / AC motor 4 x DC motor
PanzaBoard V1.1
8 Half bridges
Connectors for external I2C Compliant with Adafruit Stemma & Stemma QT modules
Fuse override jumper: Warning: Risk of overload!
Enable A&B
Universal Raspberry Pi Pico <-> educational robot interface
PanzaBoard
RP_Pico is supplied with 5V from this board.
5V output to supply external systems
5V : max 3A 3.3V: max 500mA 1.8V: max 500mA 12V : max 200mA
V1.1
5V or 3.3V inputs
ONLY 5V output NO data connection!
8 way IDC cable
Optional motor feedback 2 x (A+B+C): Quadrature encoders: A+B+(I) HALL sensors: U+V+W !!NOTE!! +5V supply
August 2024
GP22 can be used for IMU interrupt or to control bootloader mode or neither
University of Southern Denmark UAS section / Robotronix Design: Anders Stengaard Sørensen
18V battery input
3.3V outputs
Enable C
Thermal Polyfuse: Will cut circuit at overload. Will Reconnect after short cooling off. LED light up RED when fuse is disconnected.
GND & VPP disconnected for safety. Connect if needed.
Include Stemma QT I2C connector
Voltage for external I2C connector !! NOTE disconnected by default!

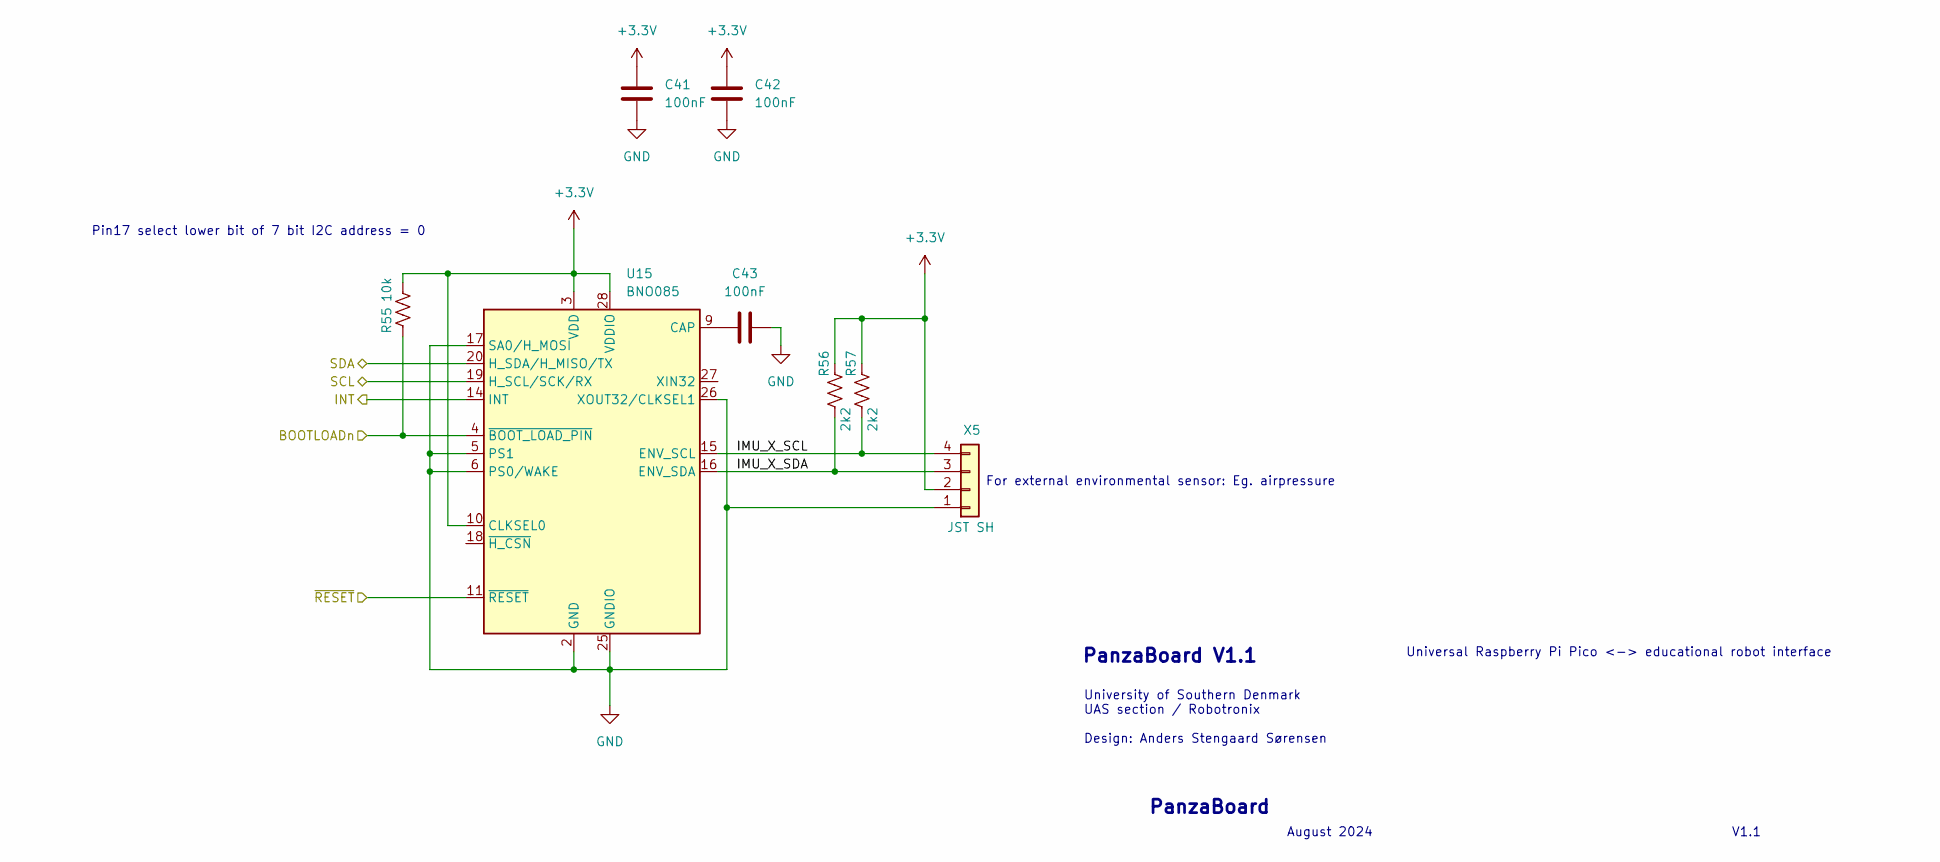
[picture p60: schematic imu_bosch.kicad_sch]

Parts:
C41, C42, C43: 100nF; C_0603_1608Metric
R55: 10k; R_0603_1608Metric
R56, R57: 2k2; R_0603_1608Metric
U15: BNO085; LGA-28_5.2x3.8mm_P0.5mm; MFR# CEVA
X5: JST SH; JST_SH_SM04B-SRSS-TB_1x04-1MP_P1.00mm_Horizontal

Connections:
/GP20: U15.20 (H_SDA/H_MISO/TX); also elsewhere on the board
/GP21: U15.19 (H_SCL/SCK/RX); also elsewhere on the board
/IMU_BOSCH/BOOTLOADn: R55.1, U15.4 (~BOOT_LOAD_PIN); also elsewhere on the board
/IMU_BOSCH/IMU_X_SCL: R57.2, U15.15 (ENV_SCL), X5.4
/IMU_BOSCH/IMU_X_SDA: R56.2, U15.16 (ENV_SDA), X5.3
/IMU_BOSCH/INT: U15.14 (INT); also elsewhere on the board
/RUN: U15.11 (~RESET); also elsewhere on the board
GND: C41.1, C42.1, C43.2, U15.2 (GND), U15.5 (PS1), U15.6 (PS0/WAKE), U15.17 (SA0/H_MOSI), U15.25 (GNDIO), U15.26 (XOUT32/CLKSEL1), X5.1; also elsewhere on the board
unnamed: C43.1, U15.9 (CAP)
SD: C41.2, C42.2, R55.2, R56.1, R57.1, U15.3 (VDD), U15.10 (CLKSEL0), U15.28 (VDDIO), X5.2; also elsewhere on the board

Notes on the sheet:
University of Southern Denmark UAS section / Robotronix Design: Anders Stengaard Sørensen
PanzaBoard V1.1
August 2024
Universal Raspberry Pi Pico <-> educational robot interface
For external environmental sensor: Eg. airpressure
PanzaBoard
V1.1
Pin17 select lower bit of 7 bit I2C address = 0

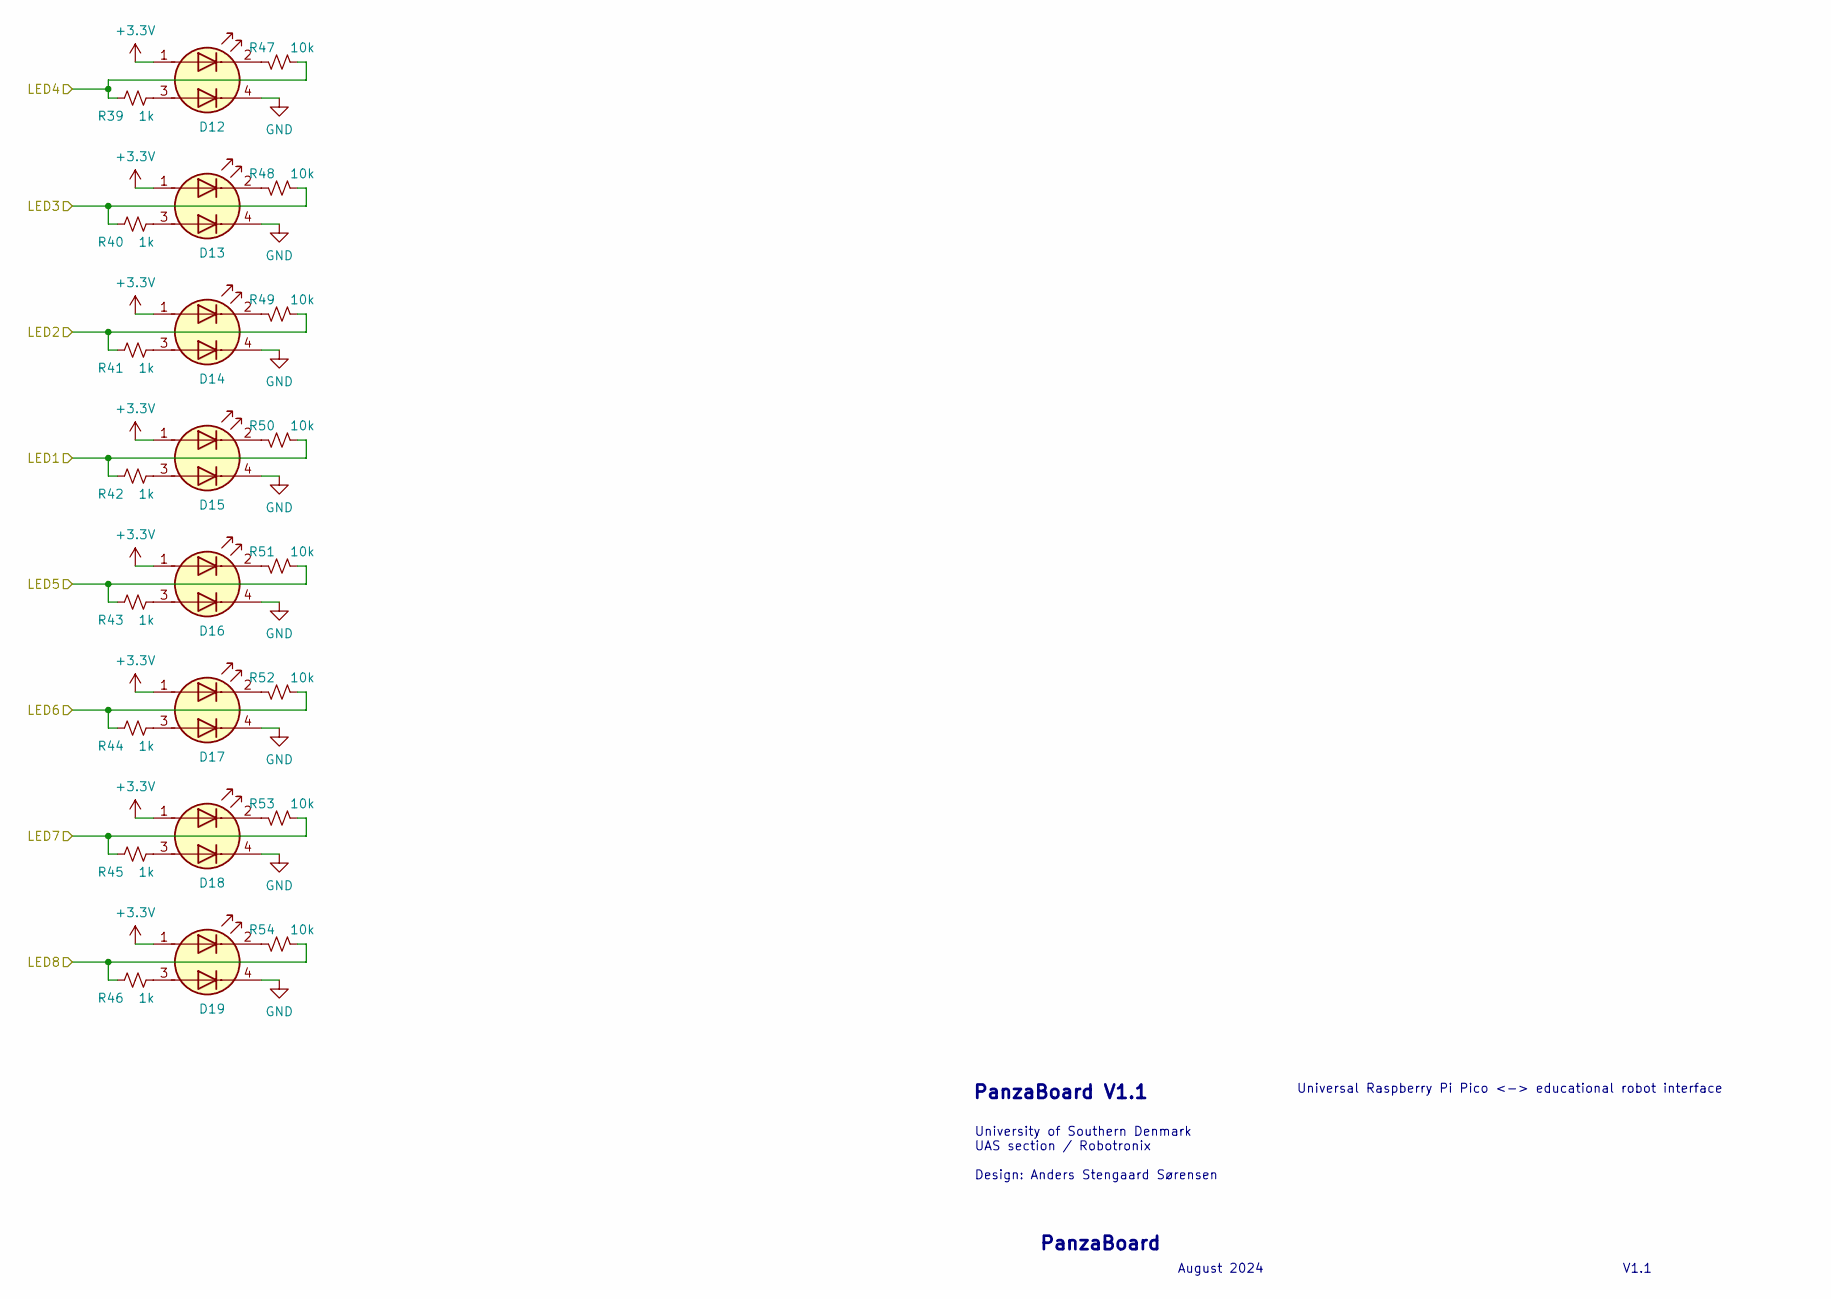
[picture p61: schematic led8.kicad_sch]

Parts:
D12, D13, D14, D15, D16, D17, D18, D19: LED_Dual_AKAK; LED_DUAL_3.2x2.7_Kingbright
R39, R40, R41, R42, R43, R44, R45, R46: 1k; R_0603_1608Metric
R47, R48, R49, R50, R51, R52, R53, R54: 10k; R_0603_1608Metric

Connections:
/GP0: R42.1, R50.2; also elsewhere on the board
/GP1: R41.1, R49.2; also elsewhere on the board
/GP2: R40.1, R48.2; also elsewhere on the board
/GP3: R39.1, R47.2; also elsewhere on the board
/GP4: R43.1, R51.2; also elsewhere on the board
/GP5: R44.1, R52.2; also elsewhere on the board
/GP6: R45.1, R53.2; also elsewhere on the board
/GP7: R46.1, R54.2; also elsewhere on the board
GND: D12.4 (K2), D13.4 (K2), D14.4 (K2), D15.4 (K2), D16.4 (K2), D17.4 (K2), D18.4 (K2), D19.4 (K2); also elsewhere on the board
unnamed: D12.3 (A2), R39.2
unnamed: D12.2 (K1), R47.1
unnamed: D13.3 (A2), R40.2
unnamed: D13.2 (K1), R48.1
unnamed: D14.3 (A2), R41.2
unnamed: D14.2 (K1), R49.1
unnamed: D15.3 (A2), R42.2
unnamed: D15.2 (K1), R50.1
unnamed: D16.3 (A2), R43.2
unnamed: D16.2 (K1), R51.1
unnamed: D17.3 (A2), R44.2
unnamed: D17.2 (K1), R52.1
unnamed: D18.3 (A2), R45.2
unnamed: D18.2 (K1), R53.1
unnamed: D19.3 (A2), R46.2
unnamed: D19.2 (K1), R54.1
SD: D12.1 (A1), D13.1 (A1), D14.1 (A1), D15.1 (A1), D16.1 (A1), D17.1 (A1), D18.1 (A1), D19.1 (A1); also elsewhere on the board

Notes on the sheet:
University of Southern Denmark UAS section / Robotronix Design: Anders Stengaard Sørensen
Universal Raspberry Pi Pico <-> educational robot interface
August 2024
V1.1
PanzaBoard
PanzaBoard V1.1

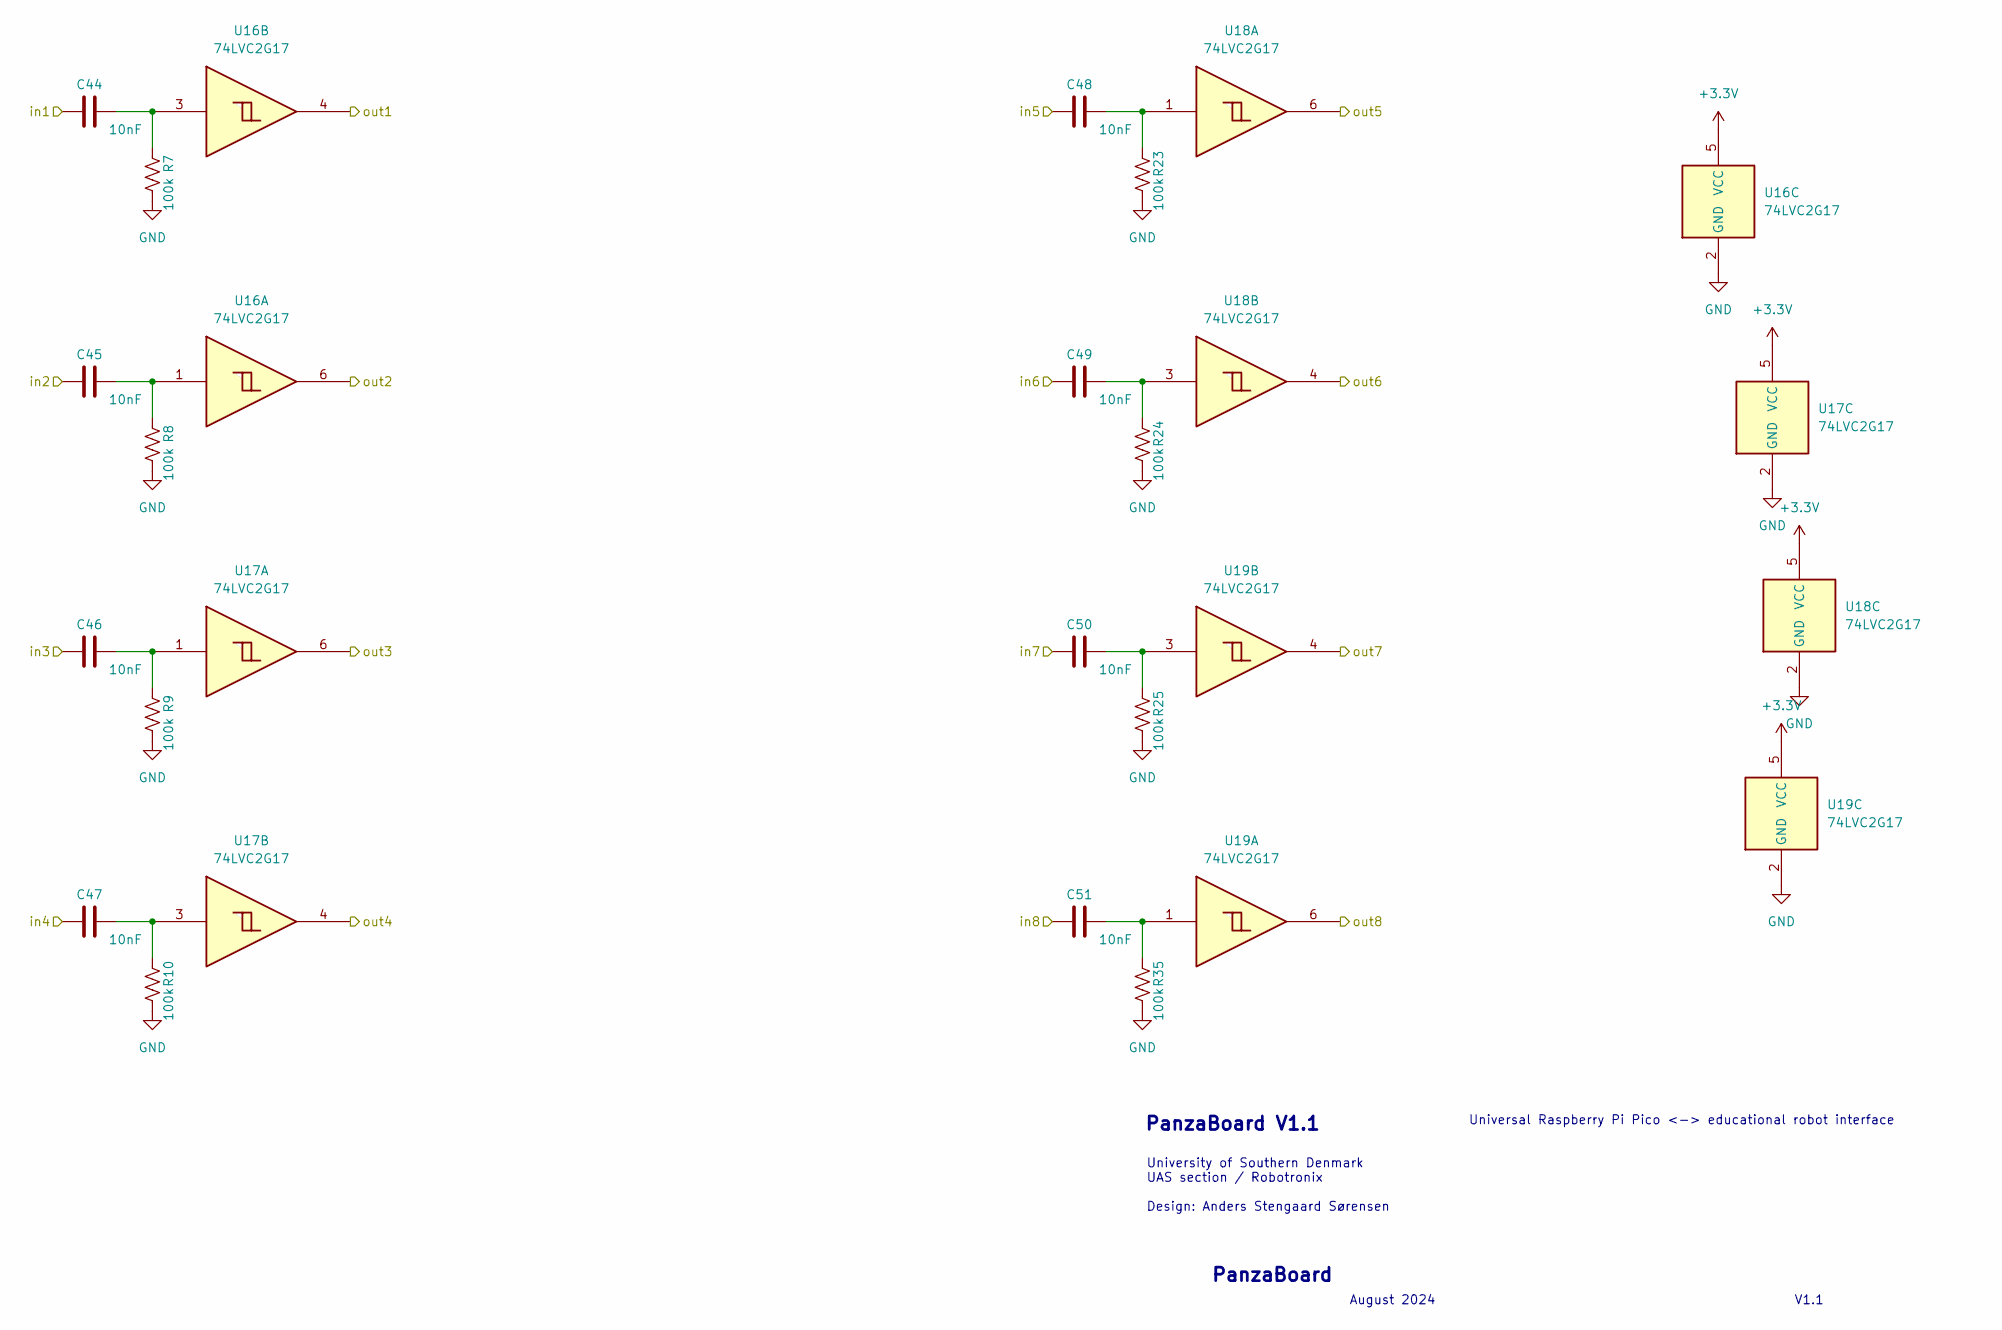
[picture p62: schematic pwmbuffer.kicad_sch]

Parts:
C44, C45, C46, C47, C48, C49, C50, C51: 10nF; C_0603_1608Metric
R7, R8, R9, R10, R23, R24, R25, R35: 100k; R_0603_1608Metric
U16, U17, U18, U19: 74LVC2G17; TSOP-6_1.65x3.05mm_P0.95mm

Connections:
/GP0: C44.2; also elsewhere on the board
/GP1: C45.2; also elsewhere on the board
/GP2: C46.2; also elsewhere on the board
/GP3: C47.2; also elsewhere on the board
/GP4: C48.2; also elsewhere on the board
/GP5: C49.2; also elsewhere on the board
/GP6: C50.2; also elsewhere on the board
/GP7: C51.2; also elsewhere on the board
/Motor drivers/PWM1: U16.4; also elsewhere on the board
/Motor drivers/PWM2: U16.6; also elsewhere on the board
/Motor drivers/PWM3: U17.6; also elsewhere on the board
/Motor drivers/PWM4: U17.4; also elsewhere on the board
/Motor drivers/PWM5: U18.6; also elsewhere on the board
/Motor drivers/PWM6: U18.4; also elsewhere on the board
/Motor drivers/PWM7: U19.4; also elsewhere on the board
/Motor drivers/PWM8: U19.6; also elsewhere on the board
GND: R7.2, R8.2, R9.2, R10.2, R23.2, R24.2, R25.2, R35.2, U16.2 (GND), U17.2 (GND), U18.2 (GND), U19.2 (GND); also elsewhere on the board
unnamed: C44.1, R7.1, U16.3
unnamed: C45.1, R8.1, U16.1
unnamed: C46.1, R9.1, U17.1
unnamed: C47.1, R10.1, U17.3
unnamed: C48.1, R23.1, U18.1
unnamed: C49.1, R24.1, U18.3
unnamed: C50.1, R25.1, U19.3
unnamed: C51.1, R35.1, U19.1
SD: U16.5 (VCC), U17.5 (VCC), U18.5 (VCC), U19.5 (VCC); also elsewhere on the board

Notes on the sheet:
Universal Raspberry Pi Pico <-> educational robot interface
August 2024
PanzaBoard V1.1
University of Southern Denmark UAS section / Robotronix Design: Anders Stengaard Sørensen
V1.1
PanzaBoard
