BigMagnus6Tips/Sememsterprojekt-grundl-ggende-styring-af-robotter/PCB_kiCad/rp2040_robotronix_v_1.1.kicad_pcb

## KiCad design PCB_kiCad/rp2040_robotronix_v_1.1.kicad_pcb (continued)

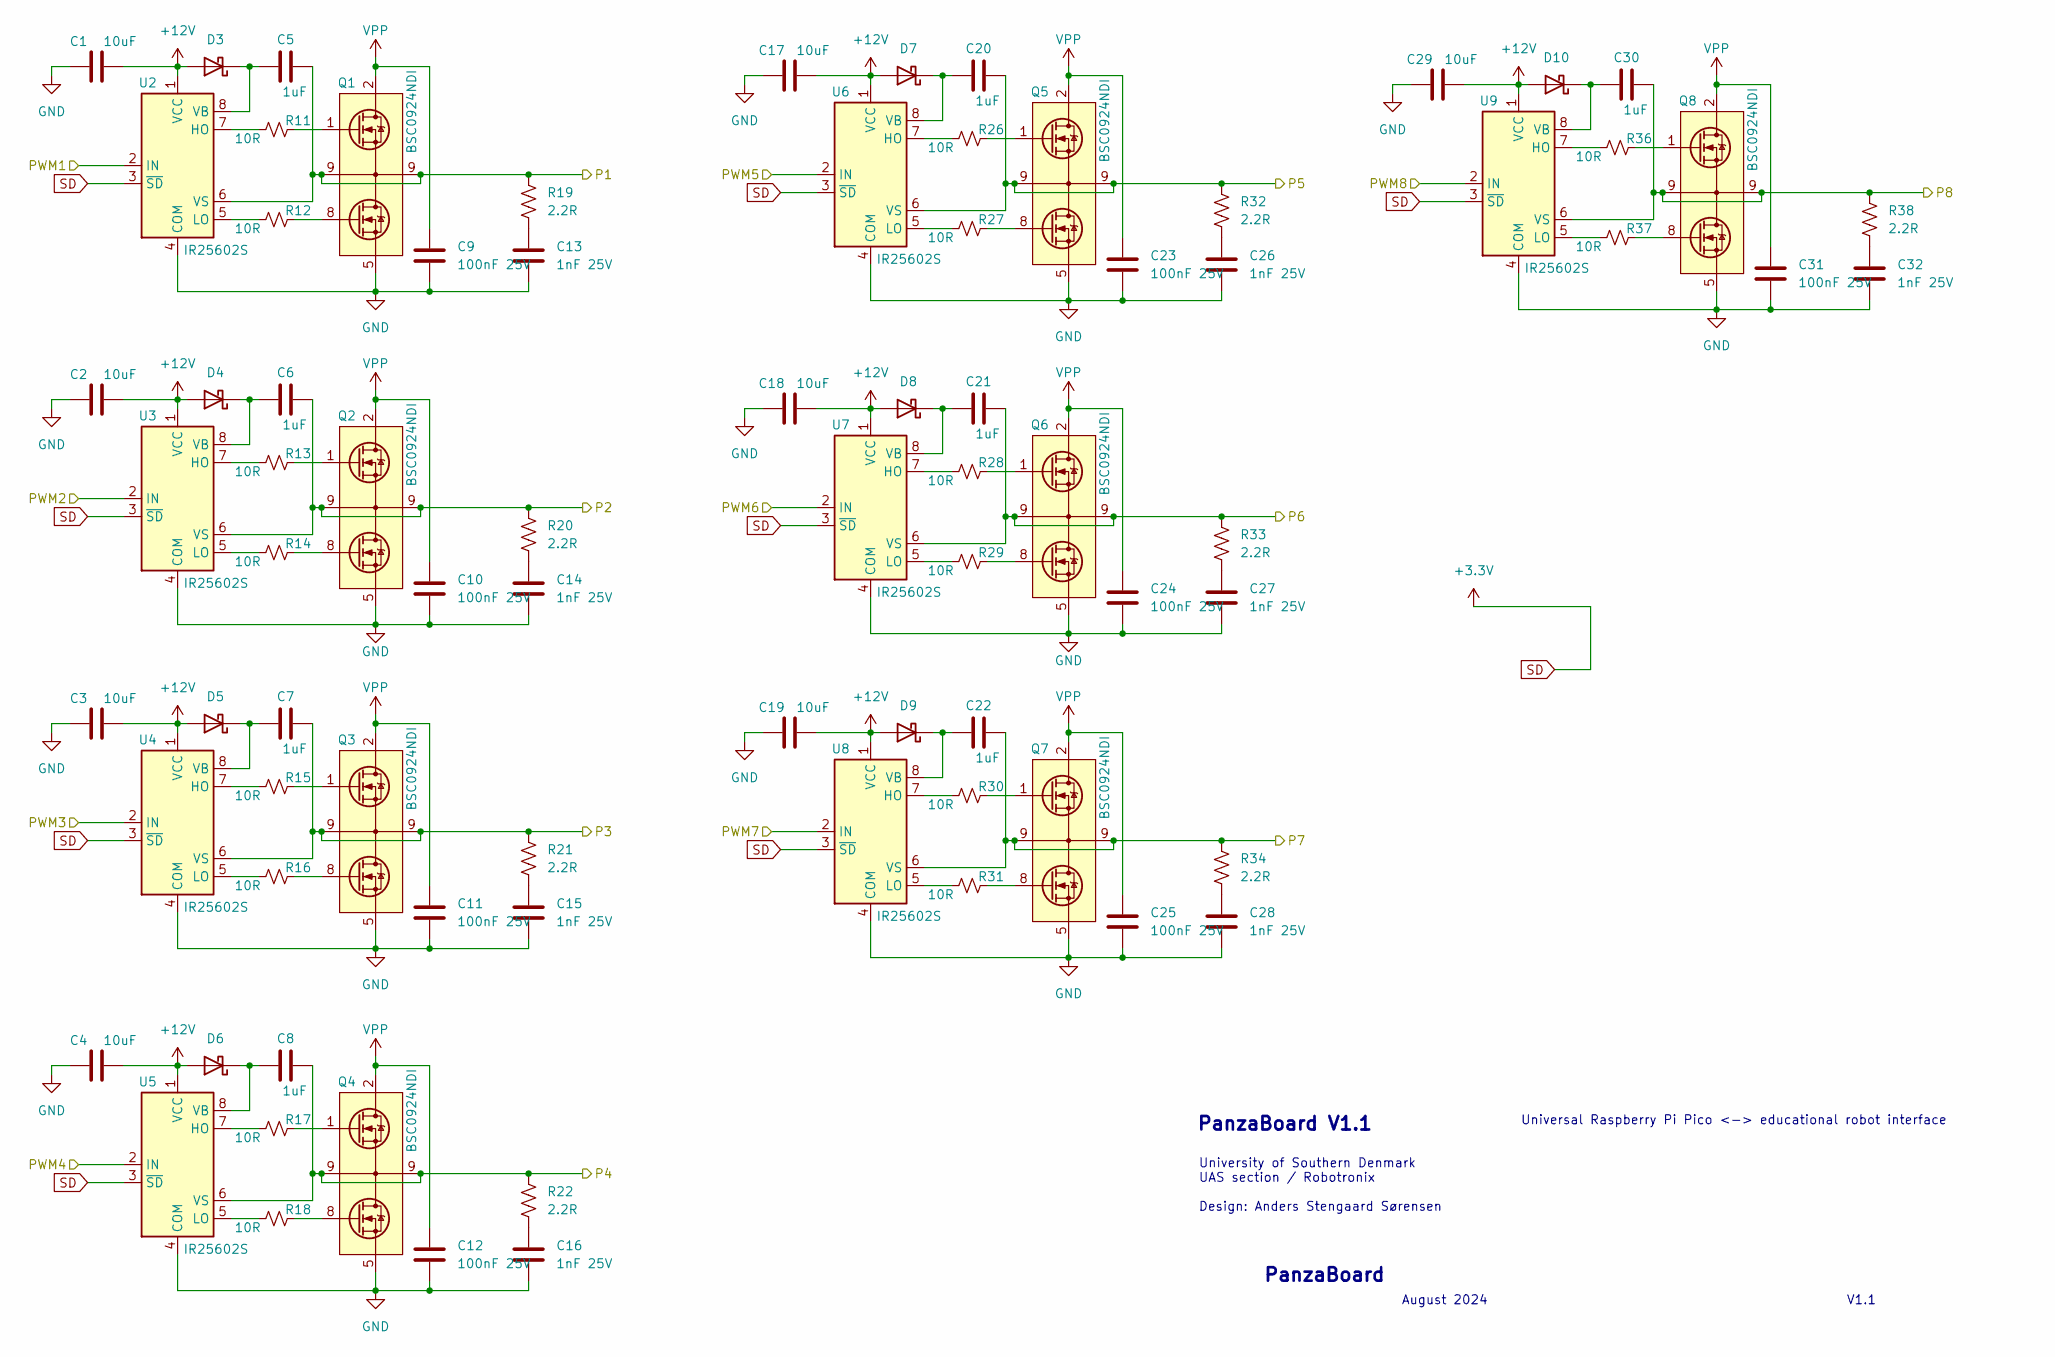
[picture p63: schematic drivers.kicad_sch]

Parts:
C1, C2, C3, C4, C17, C18, C19, C29: 10uF; C_1206_3216Metric; MFR# CL31A106KAHNFNE
C5, C6, C7, C8, C20, C21, C22, C30: 1uF; C_0603_1608Metric
C9, C10, C11, C12, C23, C24, C25, C31: 100nF 25V; C_0603_1608Metric
C13, C14, C15, C16, C26, C27, C28, C32: 1nF 25V; C_0603_1608Metric
D3, D4, D5, D6, D7, D8, D9, D10: CES521; D_SOD-523
Q1, Q2, Q3, Q4, Q5, Q6, Q7, Q8: BSC0924NDI; PG-TISON8; MFR# Infineon Technologies
R11, R12, R13, R14, R15, R16, R17, R18, R26, R27, R28, R29, R30, R31, R36, R37: 10R; R_0603_1608Metric
R19, R20, R21, R22, R32, R33, R34, R38: 2.2R; R_0603_1608Metric
U2, U3, U4, U5, U6, U7, U8, U9: IR25602S; SOIC-8_3.9x4.9mm_P1.27mm

Connections:
+12V: C1.2, C2.2, C3.2, C4.2, C17.2, C18.2, C19.2, C29.2, D3.2 (A), D4.2 (A), D5.2 (A), D6.2 (A), D7.2 (A), D8.2 (A), D9.2 (A), D10.2 (A), U2.1 (VCC), U3.1 (VCC), U4.1 (VCC), U5.1 (VCC), U6.1 (VCC), U7.1 (VCC), U8.1 (VCC), U9.1 (VCC); also elsewhere on the board
/Motor drivers/P1: C5.2, Q1.9, R19.1, U2.6 (VS); also elsewhere on the board
/Motor drivers/P2: C6.2, Q2.9, R20.1, U3.6 (VS); also elsewhere on the board
/Motor drivers/P3: C7.2, Q3.9, R21.1, U4.6 (VS); also elsewhere on the board
/Motor drivers/P4: C8.2, Q4.9, R22.1, U5.6 (VS); also elsewhere on the board
/Motor drivers/P5: C20.2, Q5.9, R32.1, U6.6 (VS); also elsewhere on the board
/Motor drivers/P6: C21.2, Q6.9, R33.1, U7.6 (VS); also elsewhere on the board
/Motor drivers/P7: C22.2, Q7.9, R34.1, U8.6 (VS); also elsewhere on the board
/Motor drivers/P8: C30.2, Q8.9, R38.1, U9.6 (VS); also elsewhere on the board
/Motor drivers/PWM1: U2.2 (IN); also elsewhere on the board
/Motor drivers/PWM2: U3.2 (IN); also elsewhere on the board
/Motor drivers/PWM3: U4.2 (IN); also elsewhere on the board
/Motor drivers/PWM4: U5.2 (IN); also elsewhere on the board
/Motor drivers/PWM5: U6.2 (IN); also elsewhere on the board
/Motor drivers/PWM6: U7.2 (IN); also elsewhere on the board
/Motor drivers/PWM7: U8.2 (IN); also elsewhere on the board
/Motor drivers/PWM8: U9.2 (IN); also elsewhere on the board
GND: C1.1, C2.1, C3.1, C4.1, C9.1, C10.1, C11.1, C12.1, C13.1, C14.1, C15.1, C16.1, C17.1, C18.1, C19.1, C23.1, C24.1, C25.1, C26.1, C27.1, C28.1, C29.1, C31.1, C32.1, Q1.5, Q1.6, Q1.7, Q2.5, Q2.6, Q2.7, Q3.5, Q3.6, Q3.7, Q4.5, Q4.6, Q4.7, Q5.5, Q5.6, Q5.7, Q6.5, Q6.6, Q6.7, Q7.5, Q7.6, Q7.7, Q8.5, Q8.6, Q8.7, U2.4 (COM), U3.4 (COM), U4.4 (COM), U5.4 (COM), U6.4 (COM), U7.4 (COM), U8.4 (COM), U9.4 (COM); also elsewhere on the board
unnamed: C13.2, R19.2
unnamed: C14.2, R20.2
unnamed: C15.2, R21.2
unnamed: C16.2, R22.2
unnamed: C26.2, R32.2
unnamed: C27.2, R33.2
unnamed: C28.2, R34.2
unnamed: C32.2, R38.2
unnamed: C5.1, D3.1 (K), U2.8 (VB)
unnamed: C6.1, D4.1 (K), U3.8 (VB)
unnamed: C7.1, D5.1 (K), U4.8 (VB)
unnamed: C8.1, D6.1 (K), U5.8 (VB)
unnamed: C20.1, D7.1 (K), U6.8 (VB)
unnamed: C21.1, D8.1 (K), U7.8 (VB)
unnamed: C22.1, D9.1 (K), U8.8 (VB)
unnamed: C30.1, D10.1 (K), U9.8 (VB)
unnamed: Q1.1, R11.2
unnamed: Q1.8, R12.2
unnamed: Q2.1, R13.2
unnamed: Q2.8, R14.2
unnamed: Q3.1, R15.2
unnamed: Q3.8, R16.2
unnamed: Q4.1, R17.2
unnamed: Q4.8, R18.2
unnamed: Q5.1, R26.2
unnamed: Q5.8, R27.2
unnamed: Q6.1, R28.2
unnamed: Q6.8, R29.2
unnamed: Q7.1, R30.2
unnamed: Q7.8, R31.2
unnamed: Q8.1, R36.2
unnamed: Q8.8, R37.2
unnamed: R11.1, U2.7 (HO)
unnamed: R12.1, U2.5 (LO)
unnamed: R13.1, U3.7 (HO)
unnamed: R14.1, U3.5 (LO)
unnamed: R15.1, U4.7 (HO)
unnamed: R16.1, U4.5 (LO)
unnamed: R17.1, U5.7 (HO)
unnamed: R18.1, U5.5 (LO)
unnamed: R26.1, U6.7 (HO)
unnamed: R27.1, U6.5 (LO)
unnamed: R28.1, U7.7 (HO)
unnamed: R29.1, U7.5 (LO)
unnamed: R30.1, U8.7 (HO)
unnamed: R31.1, U8.5 (LO)
unnamed: R36.1, U9.7 (HO)
unnamed: R37.1, U9.5 (LO)
SD: U2.3 (~SD), U3.3 (~SD), U4.3 (~SD), U5.3 (~SD), U6.3 (~SD), U7.3 (~SD), U8.3 (~SD), U9.3 (~SD); also elsewhere on the board
VPP: C9.2, C10.2, C11.2, C12.2, C23.2, C24.2, C25.2, C31.2, Q1.2, Q1.3, Q1.4, Q2.2, Q2.3, Q2.4, Q3.2, Q3.3, Q3.4, Q4.2, Q4.3, Q4.4, Q5.2, Q5.3, Q5.4, Q6.2, Q6.3, Q6.4, Q7.2, Q7.3, Q7.4, Q8.2, Q8.3, Q8.4; also elsewhere on the board

Notes on the sheet:
PanzaBoard
University of Southern Denmark UAS section / Robotronix Design: Anders Stengaard Sørensen
V1.1
August 2024
Universal Raspberry Pi Pico <-> educational robot interface
PanzaBoard V1.1

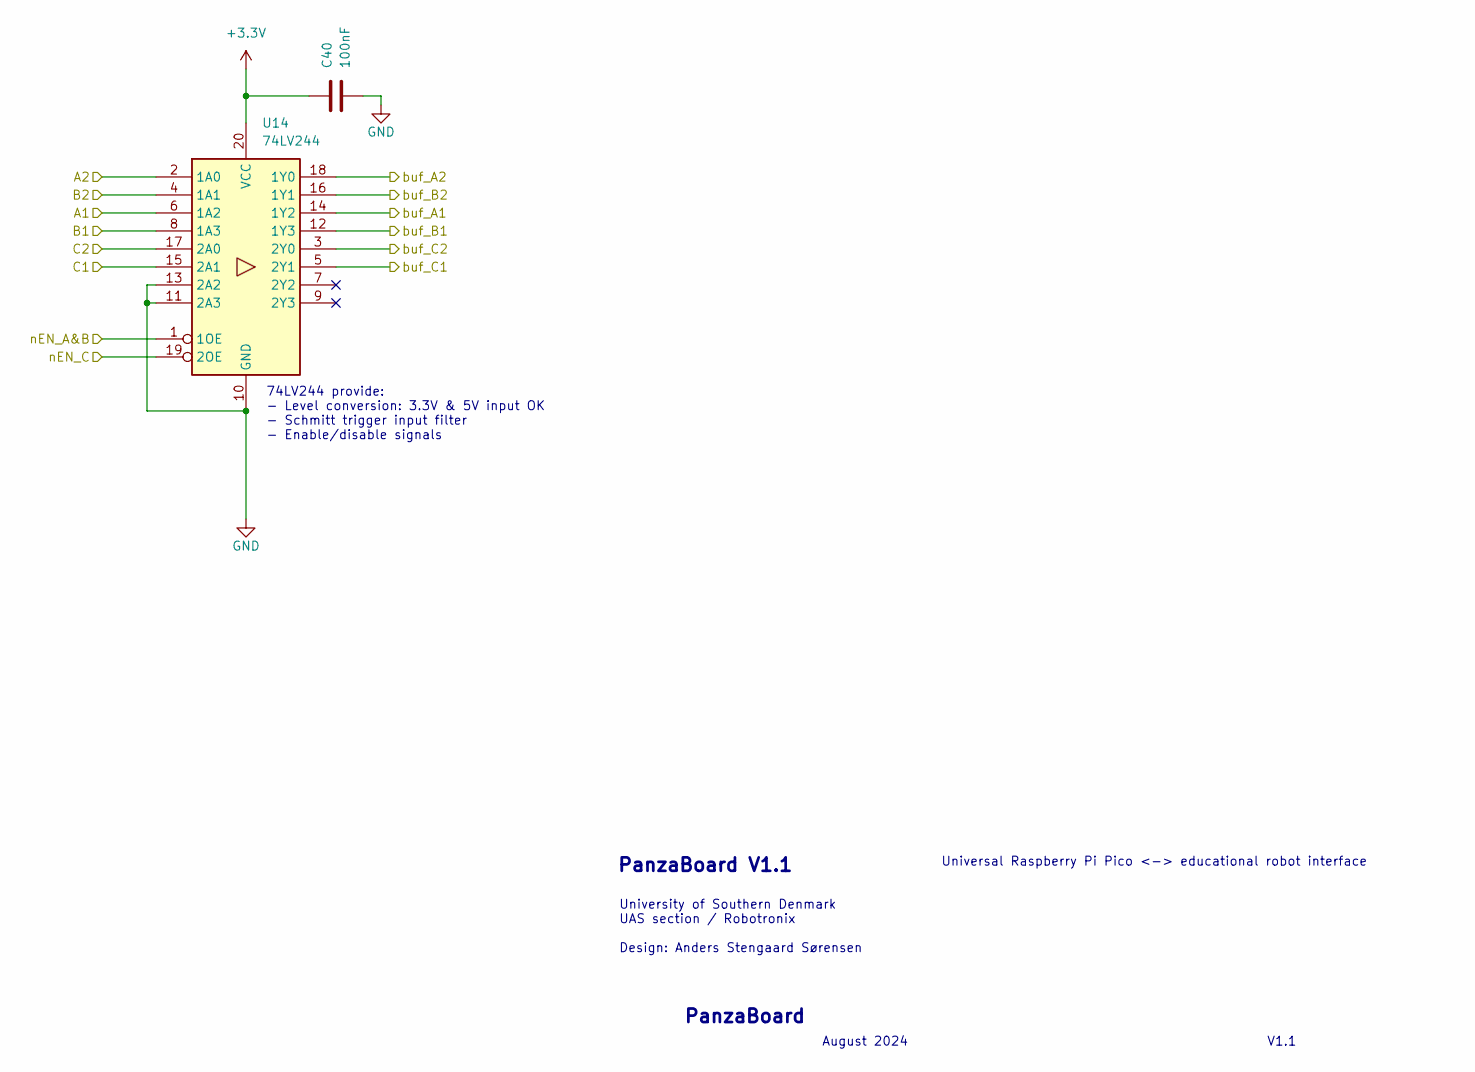
[picture p64: schematic inputbuffer.kicad_sch]

Parts:
C40: 100nF; C_0603_1608Metric
U14: 74LV244; TSSOP-20_4.4x6.5mm_P0.65mm; MFR# Nexperia

Connections:
/GP8: U14.5 (2Y1); also elsewhere on the board
/GP9: U14.3 (2Y0); also elsewhere on the board
/GP12: U14.12 (1Y3); also elsewhere on the board
/GP13: U14.14 (1Y2); also elsewhere on the board
/GP14: U14.16 (1Y1); also elsewhere on the board
/GP15: U14.18 (1Y0); also elsewhere on the board
/Input buffer/A1: U14.6 (1A2); also elsewhere on the board
/Input buffer/A2: U14.2 (1A0); also elsewhere on the board
/Input buffer/B1: U14.8 (1A3); also elsewhere on the board
/Input buffer/B2: U14.4 (1A1); also elsewhere on the board
/Input buffer/C1: U14.15 (2A1); also elsewhere on the board
/Input buffer/C2: U14.17 (2A0); also elsewhere on the board
/Input buffer/nEN_A&B: U14.1 (1OE); also elsewhere on the board
/Input buffer/nEN_C: U14.19 (2OE); also elsewhere on the board
GND: C40.1, U14.10 (GND), U14.11 (2A3), U14.13 (2A2); also elsewhere on the board
SD: C40.2, U14.20 (VCC); also elsewhere on the board

Notes on the sheet:
University of Southern Denmark UAS section / Robotronix Design: Anders Stengaard Sørensen
PanzaBoard V1.1
Universal Raspberry Pi Pico <-> educational robot interface
74LV244 provide: - Level conversion: 3.3V & 5V input OK - Schmitt trigger input filter - Enable/disable signals
August 2024
V1.1
PanzaBoard

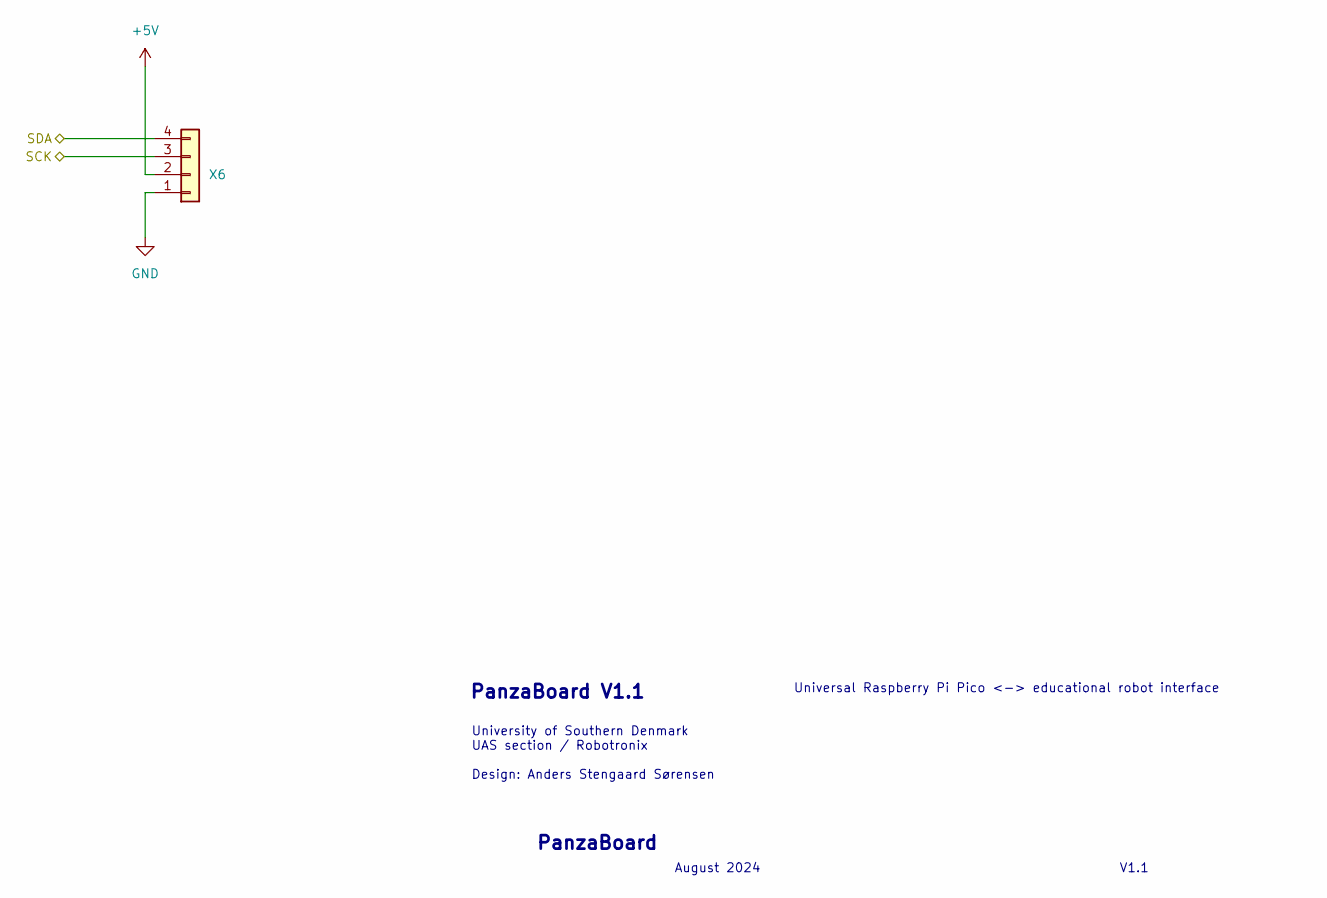
[picture p65: schematic oled.kicad_sch]

Parts:
X6: Conn_01x04; Molex_KK-254_AE-6410-04A_1x04_P2.54mm_Vertical

Connections:
+5V: X6.2; also elsewhere on the board
/GP20: X6.4; also elsewhere on the board
/GP21: X6.3; also elsewhere on the board
GND: X6.1; also elsewhere on the board

Notes on the sheet:
Universal Raspberry Pi Pico <-> educational robot interface
PanzaBoard V1.1
August 2024
PanzaBoard
V1.1
University of Southern Denmark UAS section / Robotronix Design: Anders Stengaard Sørensen

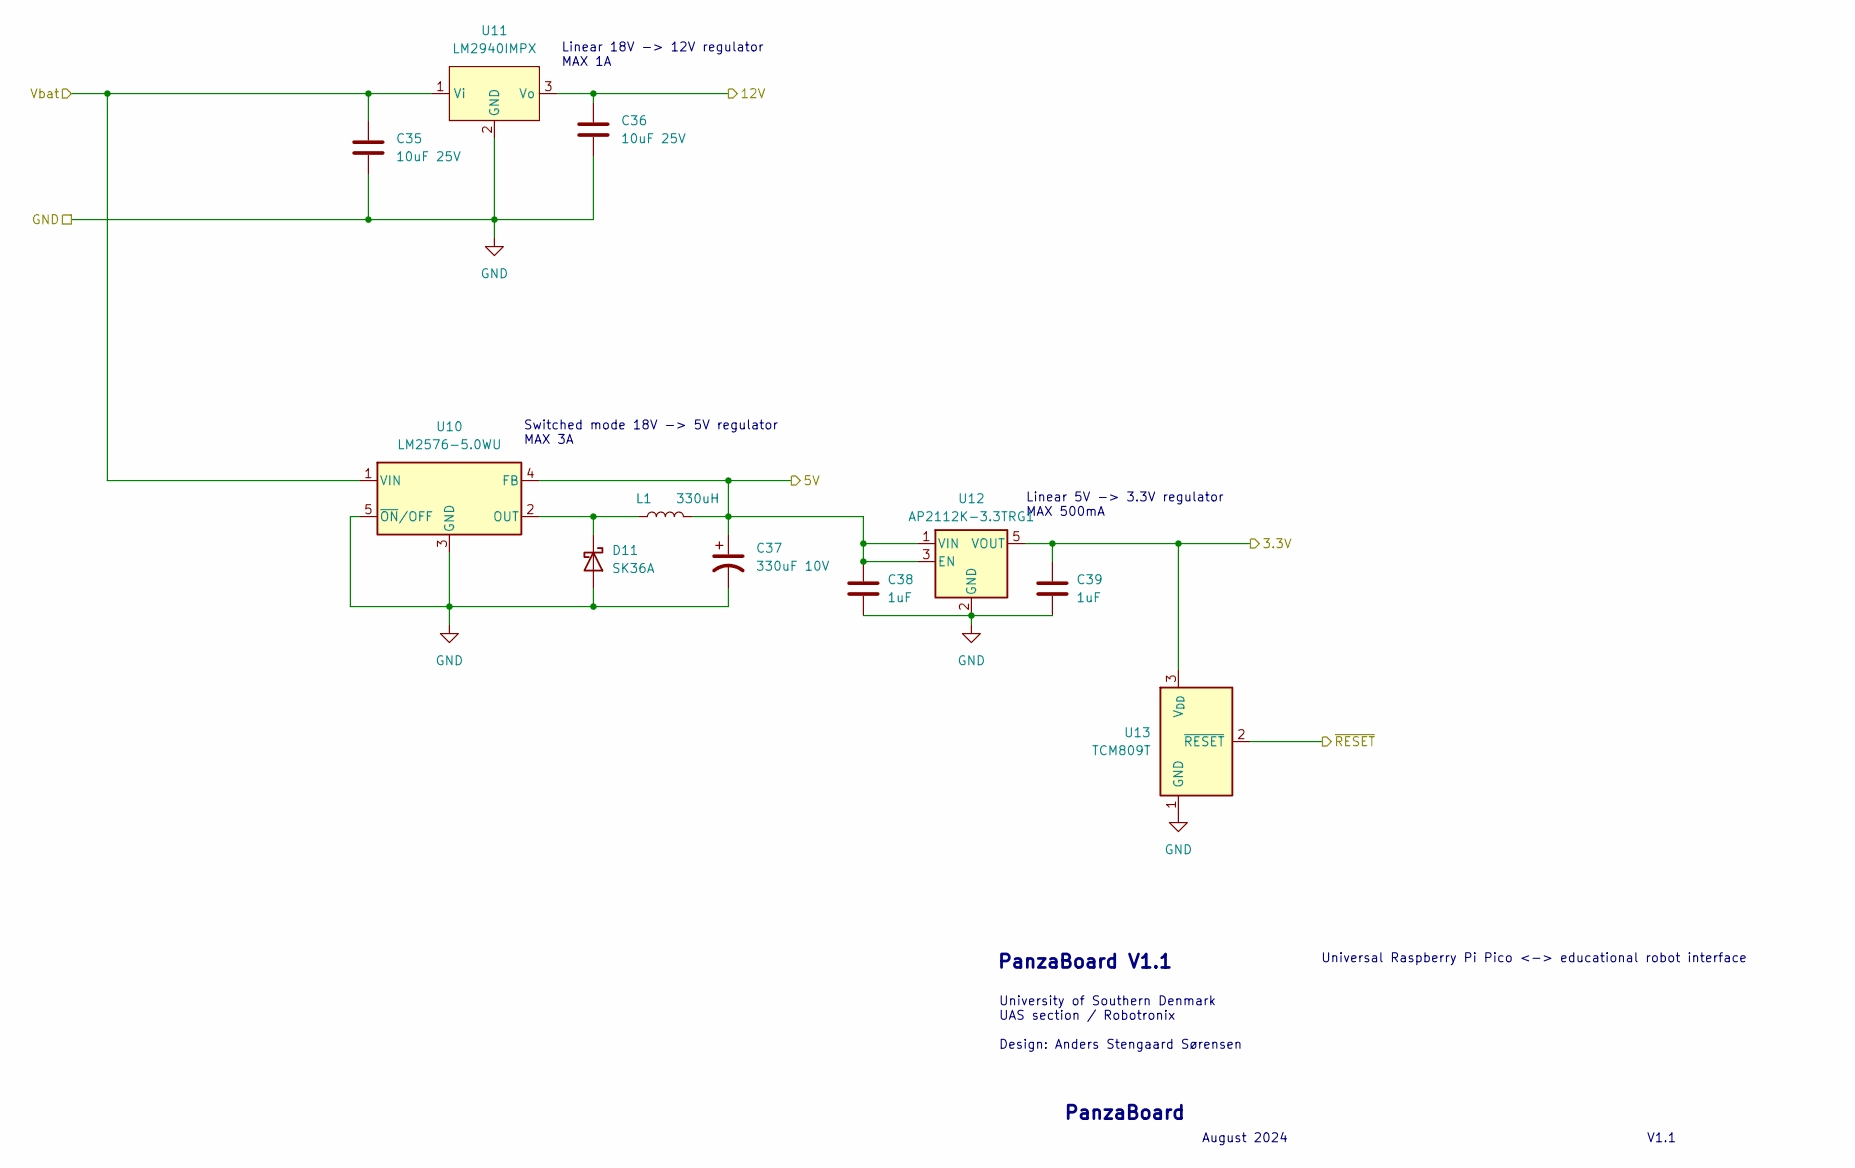
[picture p66: schematic psu.kicad_sch]

Parts:
C35, C36: 10uF 25V; C_1206_3216Metric; MFR# CL31A106KAHNFNE
C37: 330uF 10V; CP_Radial_D10.0mm_P5.00mm; MFR# Wurth Elektronik
C38, C39: 1uF; C_1206_3216Metric; MFR# CC0603KPX5R8BB105
D11: SK36A; D_SMA; MFR# Micro Commercial Components (MCC)
L1: 330uH; L_Murata_6000B; MFR# Murata Power Solutions
U10: LM2576-5.0WU; TO-263-5_TabPin3; MFR# Microchip Technology
U11: LM2940IMPX; SOT-223-3_TabPin2
U12: AP2112K-3.3TRG1; SOT-23-5; MFR# Diodes Incorporated
U13: TCM809T; SOT-323_SC-70; MFR# Microchip Technology

Connections:
+5V: C37.1, C38.1, L1.2, U10.4 (FB), U12.1 (VIN), U12.3 (EN); also elsewhere on the board
+12V: C36.1, U11.3 (Vo); also elsewhere on the board
/RUN: U13.2 (~RESET); also elsewhere on the board
GND: C35.2, C36.2, C37.2, C38.2, C39.2, D11.2 (A), U10.3 (GND), U10.5 (~ON/OFF), U11.2 (GND), U12.2 (GND), U13.1 (GND); also elsewhere on the board
unnamed: D11.1 (K), L1.1, U10.2 (OUT)
SD: C39.1, U12.5 (VOUT), U13.3 (V_{DD}); also elsewhere on the board
Vbat: C35.1, U10.1 (VIN), U11.1 (Vi); also elsewhere on the board

Notes on the sheet:
Linear 5V -> 3.3V regulator MAX 500mA
August 2024
University of Southern Denmark UAS section / Robotronix Design: Anders Stengaard Sørensen
Universal Raspberry Pi Pico <-> educational robot interface
Linear 18V -> 12V regulator MAX 1A
PanzaBoard V1.1
Switched mode 18V -> 5V regulator MAX 3A
PanzaBoard
V1.1

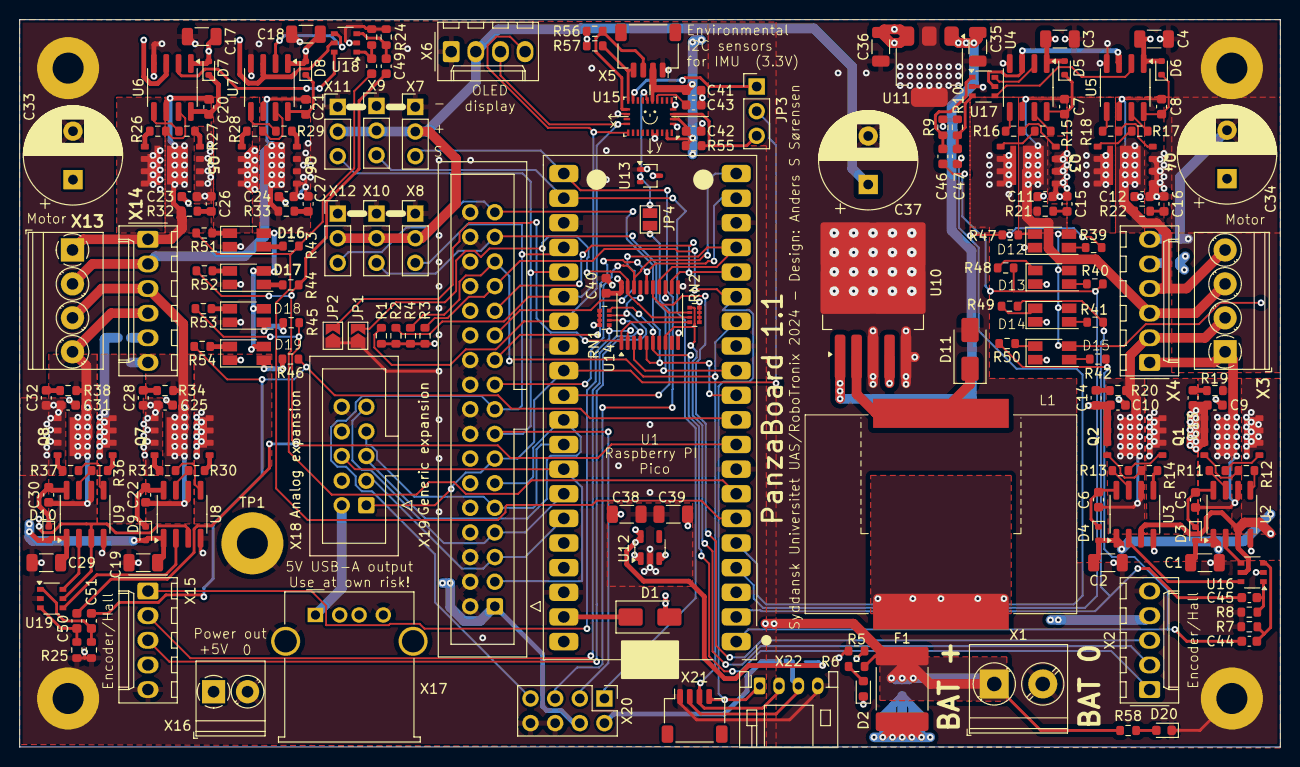
[picture p67: board rp2040_robotronix_v_1.1.kicad_pcb from above]

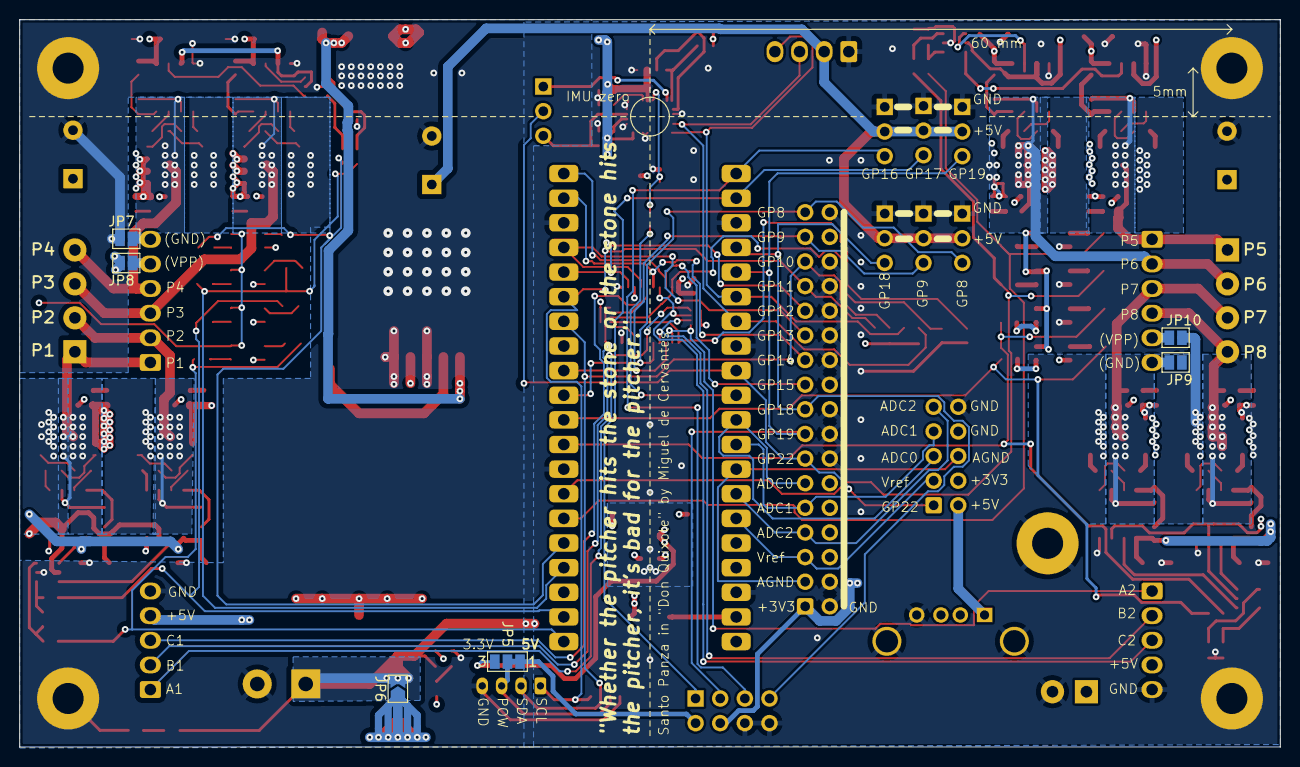
[picture p68: board rp2040_robotronix_v_1.1.kicad_pcb from below]

Board: 4 copper layers, 130.0 x 75.0 mm, 197 parts (6 on the bottom side), 146 nets.
