BigMagnus6Tips/Sememsterprojekt-grundl-ggende-styring-af-robotter/kiCad_LDR_flip_flop/kiCad_LDR_flip_flop.kicad_pcb

## KiCad design kiCad_LDR_flip_flop/kiCad_LDR_flip_flop.kicad_pcb (2024-12-16)

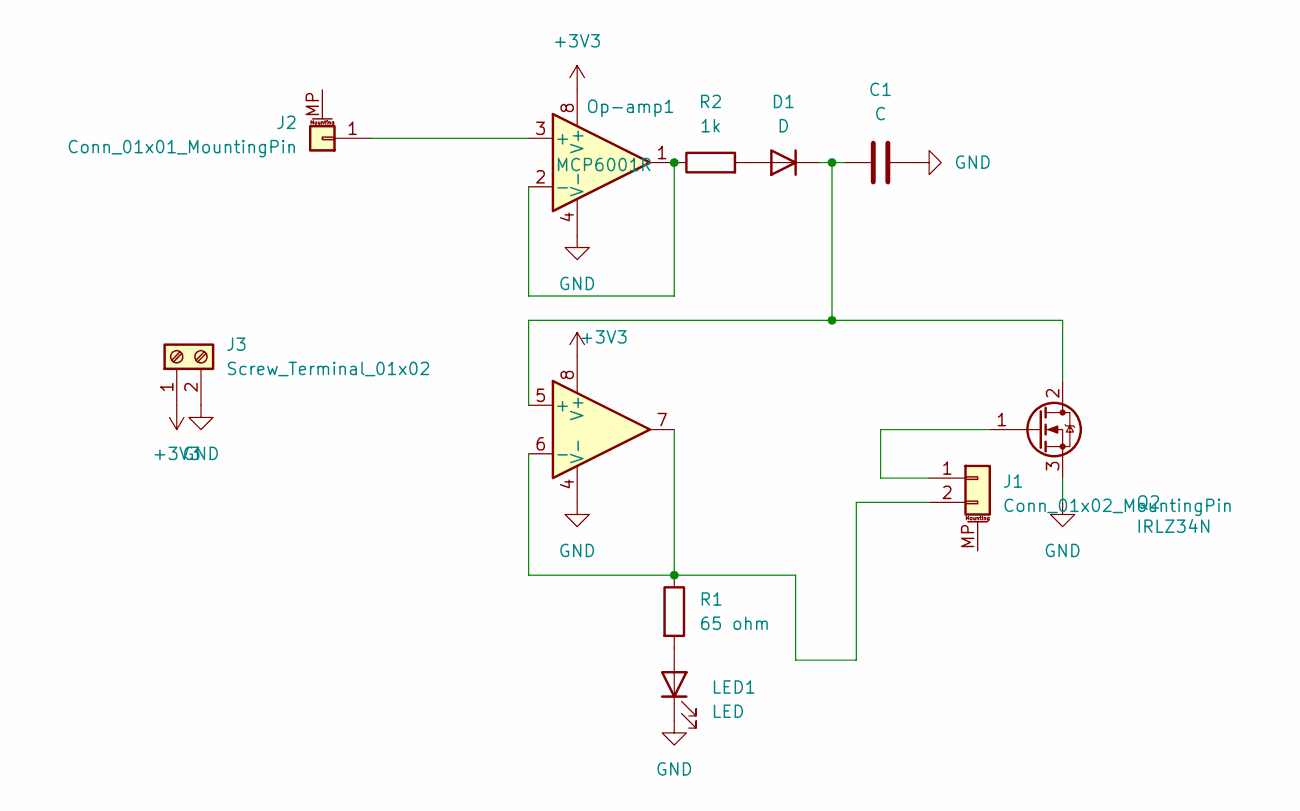
[picture p69: schematic kiCad_LDR_flip_flop.kicad_sch]

Parts:
C1: C; C_Disc_D11.0mm_W5.0mm_P5.00mm
D1: D; D_5W_P10.16mm_Horizontal
J1: Conn_01x02_MountingPin; PinSocket_1x02_P2.54mm_Vertical
J2: Conn_01x01_MountingPin
J3: Screw_Terminal_01x02; TerminalBlock_Phoenix_MKDS-1,5-2_1x02_P5.00mm_Horizontal
LED1: LED; LED_D1.8mm_W3.3mm_H2.4mm
Op-amp1: MCP6001R; DIP-8_W7.62mm
Q2: IRLZ34N; TO-220-3_Vertical
R1: 65 ohm; R_Axial_DIN0204_L3.6mm_D1.6mm_P7.62mm_Horizontal
R2: 1k; R_Axial_DIN0204_L3.6mm_D1.6mm_P7.62mm_Horizontal

Connections:
+3V3: J3.1, Op-amp1.8 (V+)
GND: C1.2, J3.2, LED1.1 (K), Op-amp1.4 (V-), Q2.3 (S)
unnamed: D1.2 (A), R2.2
unnamed: C1.1, D1.1 (K), Op-amp1.5 (+), Q2.2 (D)
unnamed: J1.1, Q2.1 (G)
unnamed: J1.2, Op-amp1.6 (-), Op-amp1.7, R1.1
unnamed: J2.1, Op-amp1.3 (+)
unnamed: LED1.2 (A), R1.2
unnamed: Op-amp1.1, Op-amp1.2 (-), R2.1

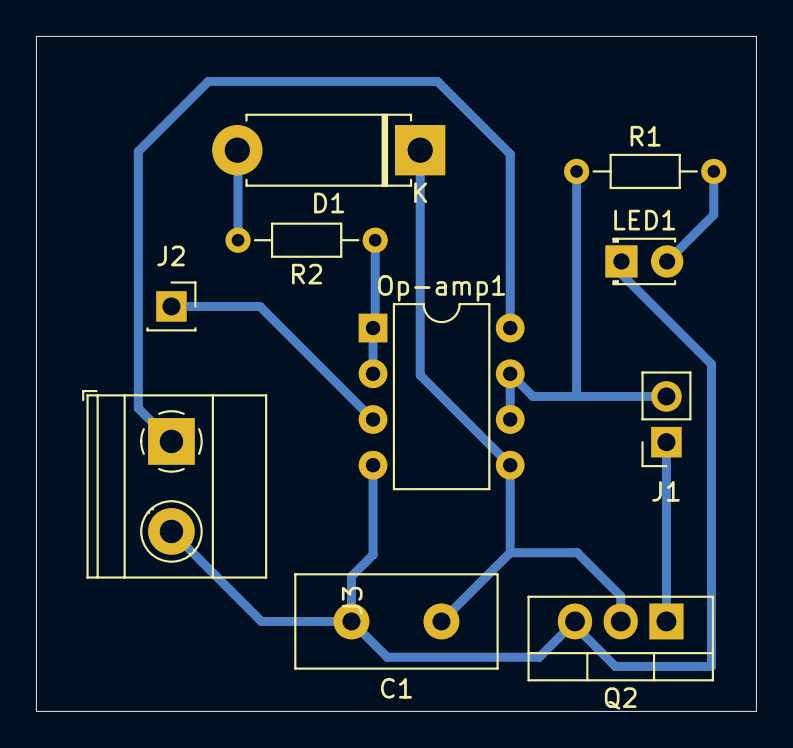
[picture p70: board kiCad_LDR_flip_flop.kicad_pcb from above]

Board: 2 copper layers, 40.0 x 37.5 mm, 10 parts (0 on the bottom side), 9 nets.
