BigMagnus6Tips/Sememsterprojekt-grundl-ggende-styring-af-robotter/controller semesterprojekt/controller semesterprojekt.kicad_pcb

## KiCad design controller semesterprojekt/controller semesterprojekt.kicad_pcb (2024-11-27)

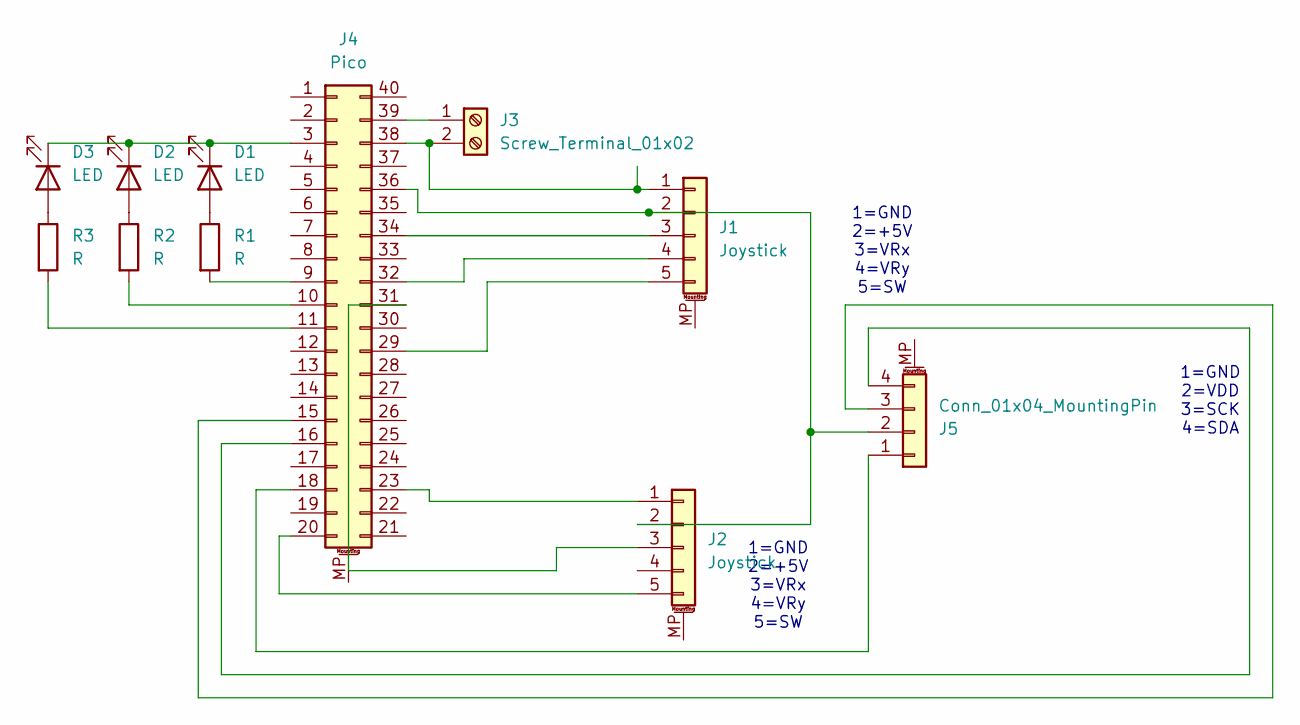
[picture p71: schematic controller semesterprojekt.kicad_sch]

Parts:
D1, D2, D3: LED; LED_D3.0mm
J1, J2: Joystick; PinSocket_1x05_P2.54mm_Vertical
J3: Screw_Terminal_01x02; TerminalBlock_Phoenix_MKDS-1,5-2-5.08_1x02_P5.08mm_Horizont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
J4: Pico; RP_pico
J5: Conn_01x04_MountingPin; PinSocket_1x04_P2.54mm_Vertical
R1, R2, R3: R; R_Axial_DIN0309_L9.0mm_D3.2mm_P15.24mm_Horizontal

Connections:
unnamed: D1.2 (A), R1.1
unnamed: D1.1 (K), D2.1 (K), D3.1 (K), J4.3
unnamed: D2.2 (A), R2.1
unnamed: D3.2 (A), R3.1
unnamed: J1.1, J3.2, J4.38
unnamed: J1.2, J2.2, J4.36, J5.2
unnamed: J1.3, J4.34
unnamed: J1.4, J4.32
unnamed: J1.5, J4.29
unnamed: J2.1, J4.23
unnamed: J2.3, J4.31
unnamed: J2.5, J4.20
unnamed: J3.1, J4.39
unnamed: J4.9, R1.2
unnamed: J4.10, R2.2
unnamed: J4.11, R3.2
unnamed: J4.15, J5.3
unnamed: J4.16, J5.4
unnamed: J4.18, J5.1

Notes on the sheet:
1=GND 2=VDD 3=SCK 4=SDA
1=GND 2=+5V 3=VRx 4=VRy 5=SW

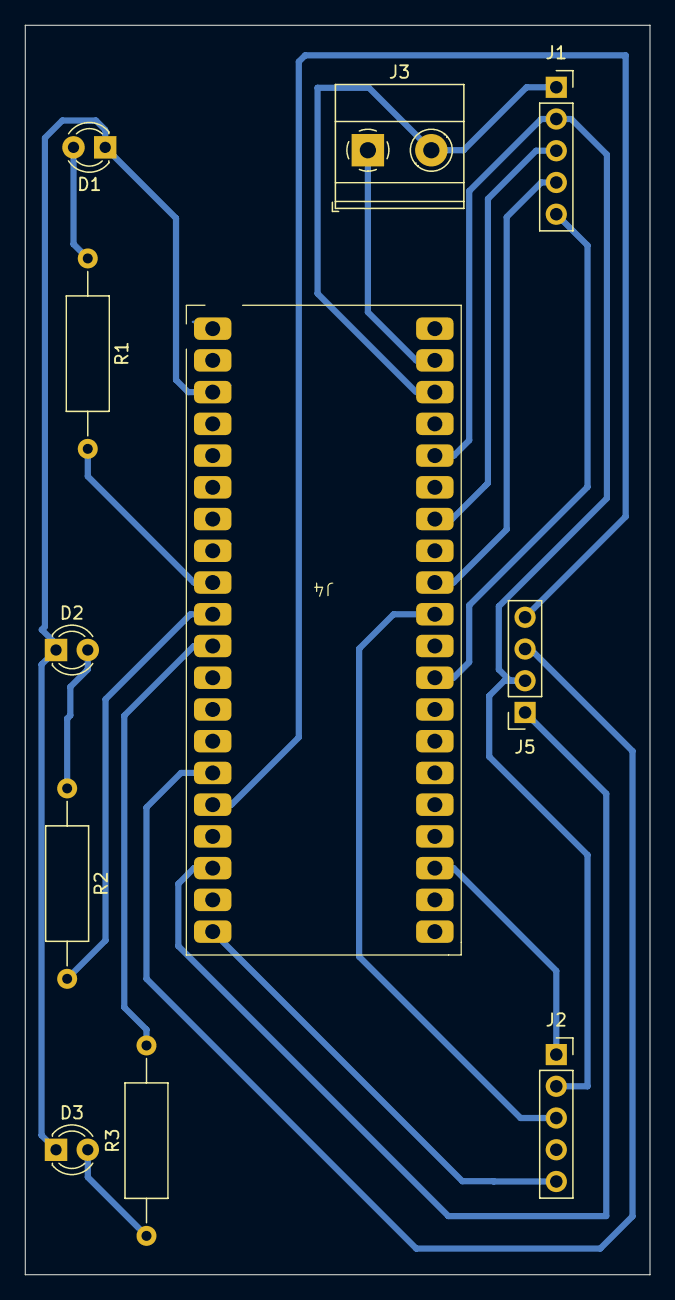
[picture p72: board controller semesterprojekt.kicad_pcb from above]

Board: 2 copper layers, 50.0 x 100.0 mm, 11 parts (0 on the bottom side), 19 nets.
