BigMagnus6Tips/Sememsterprojekt-grundl-ggende-styring-af-robotter/(commit log)

2024-11-06 Opgave 2.3ish
    [data_log.csv, data_log2.csv]
2024-11-11 LED/LDR hardware integration
    [data_log3.csv, data_log4.csv, data_log5.csv, data_log6.csv, data_log7.csv, data_log8.csv, data_log9.csv, data_log_finalTest.csv]
2024-11-15 flowchart opdatering i bunden
2024-11-17 ny flowchart
2024-11-18 new dataplots
    [without_shield_with_LED1.csv, without_shield_with_LED2.csv]
2024-11-18 pcb images
2024-11-22 added kicad files including controller
    [controller semesterprojekt.kicad_pcb, controller semesterprojekt.kicad_sch]
2024-11-25 Updated kiCad
    [controller semesterprojekt.kicad_pcb]
2024-11-25 Updated kicad_pcb
2024-11-28 OLED og Kicad for elektromagnet og LDR boards
    [Board_LDR.kicad_pcb, Board_LDR.kicad_sch, KiCad_Elektromagnet.kicad_pcb, KiCad_Elektromagnet.kicad_sch]
2024-11-28 updated joystick to include button
2024-11-28 made it work wireless with bluetooth
2024-11-28 button added
2024-12-01 updated comments to have the same language and case
2024-12-05 Portfolie 3 changes
    [without_shield_with_LED1.csv, without_shield_with_LED2.csv]
2024-12-05 portfolie 3 fix
    [FinalTestWithoutShield1.csv, data_log.csv, data_log2.csv, data_log3.csv, data_log4.csv, data_log5.csv, data_log6.csv, data_log7.csv]
2024-12-12 made things to portfolio 3
    [FinalTestWithLED.csv, FinalTestWithLEDAndShield.csv, FinalTestWithoutLEDButShield.csv, FinalTestWithoutShield1.csv]
2024-12-12 added kicad to comparator
    [LDRcomperator.kicad_pcb, LDRcomperator.kicad_sch]
2024-12-12 added interrupt for firemacking
2024-12-13 modified kicad for LDR
2024-12-13 Added test for homing function
2024-12-15 updated the LDRComperator kicad drawing
    [LDRcomperator.kicad_pcb, LDRcomperator.kicad_sch]
2024-12-15 kicad improvments for ldrCompartor
    [LDRcomperator.kicad_pcb, LDRcomperator.kicad_sch]
2024-12-15 mindre ændringer til humle samt legacy kode fra pf2
    [left_coordinates.csv, right_coordinates.csv]
2024-12-16 ændringer til coordinatesplotter
    [right_coordinates.csv]
2024-12-16 uploaded PCB kicad filer
    [drivers.kicad_sch, imu.kicad_sch, imu_bosch.kicad_sch, inputbuffer.kicad_sch, led8.kicad_sch, oled.kicad_sch, psu.kicad_sch, pwmbuffer.kicad_sch]
2024-12-16 pick up bolt function
2024-12-16 minor changes
    [right_coordinates.csv]
2024-12-16 added kicad flip flop thing
    [kiCad_LDR_flip_flop.kicad_pcb, kiCad_LDR_flip_flop.kicad_sch]
2024-12-16 made flip flop work
    [LDRcomperator.kicad_pcb, LDRcomperator.kicad_sch, kiCad_LDR_flip_flop.kicad_sch]
2024-12-16 Elektromagnet kicad
    [Board_LDR.kicad_sch, Elektromagnet print.kicad_pcb, Elektromagnet print.kicad_sch, KiCad_Elektromagnet.kicad_sch]
2024-12-16 Kicad 2
    [Elektromagnet print.kicad_pcb]
2024-12-16 added bolt coords
2024-12-17 ny lightning mcqueen kode med flip flop
    [main.py, test.py]
2024-12-17 did something with kicad idk
    [kiCad_OLED_and_button.kicad_pcb, kiCad_OLED_and_button.kicad_sch]
2024-12-17 commit for mcking trying using flip flop
    [OptimizedStepperClasses.py, main.py]
2024-12-17 major changes
    [right_coordinates.csv]
2025-01-06 KiCad changes
    [LDRcomperator.kicad_pcb, kiCad_LDR_flip_flop.kicad_sch]
2025-01-06 kicad stuuf idk
    [kiCad_OLED_and_button.kicad_pcb, kiCad_OLED_and_button.kicad_sch]
2025-01-23 Bare haft kigget på KiCad tegningerne
    [Elektromagnet print.kicad_sch]
